NSLS2/zupsc-hw/daughter/rev2/psc_daughter_brd.kicad_pcb

## KiCad design daughter/rev2/psc_daughter_brd.kicad_pcb (2026-09-02)

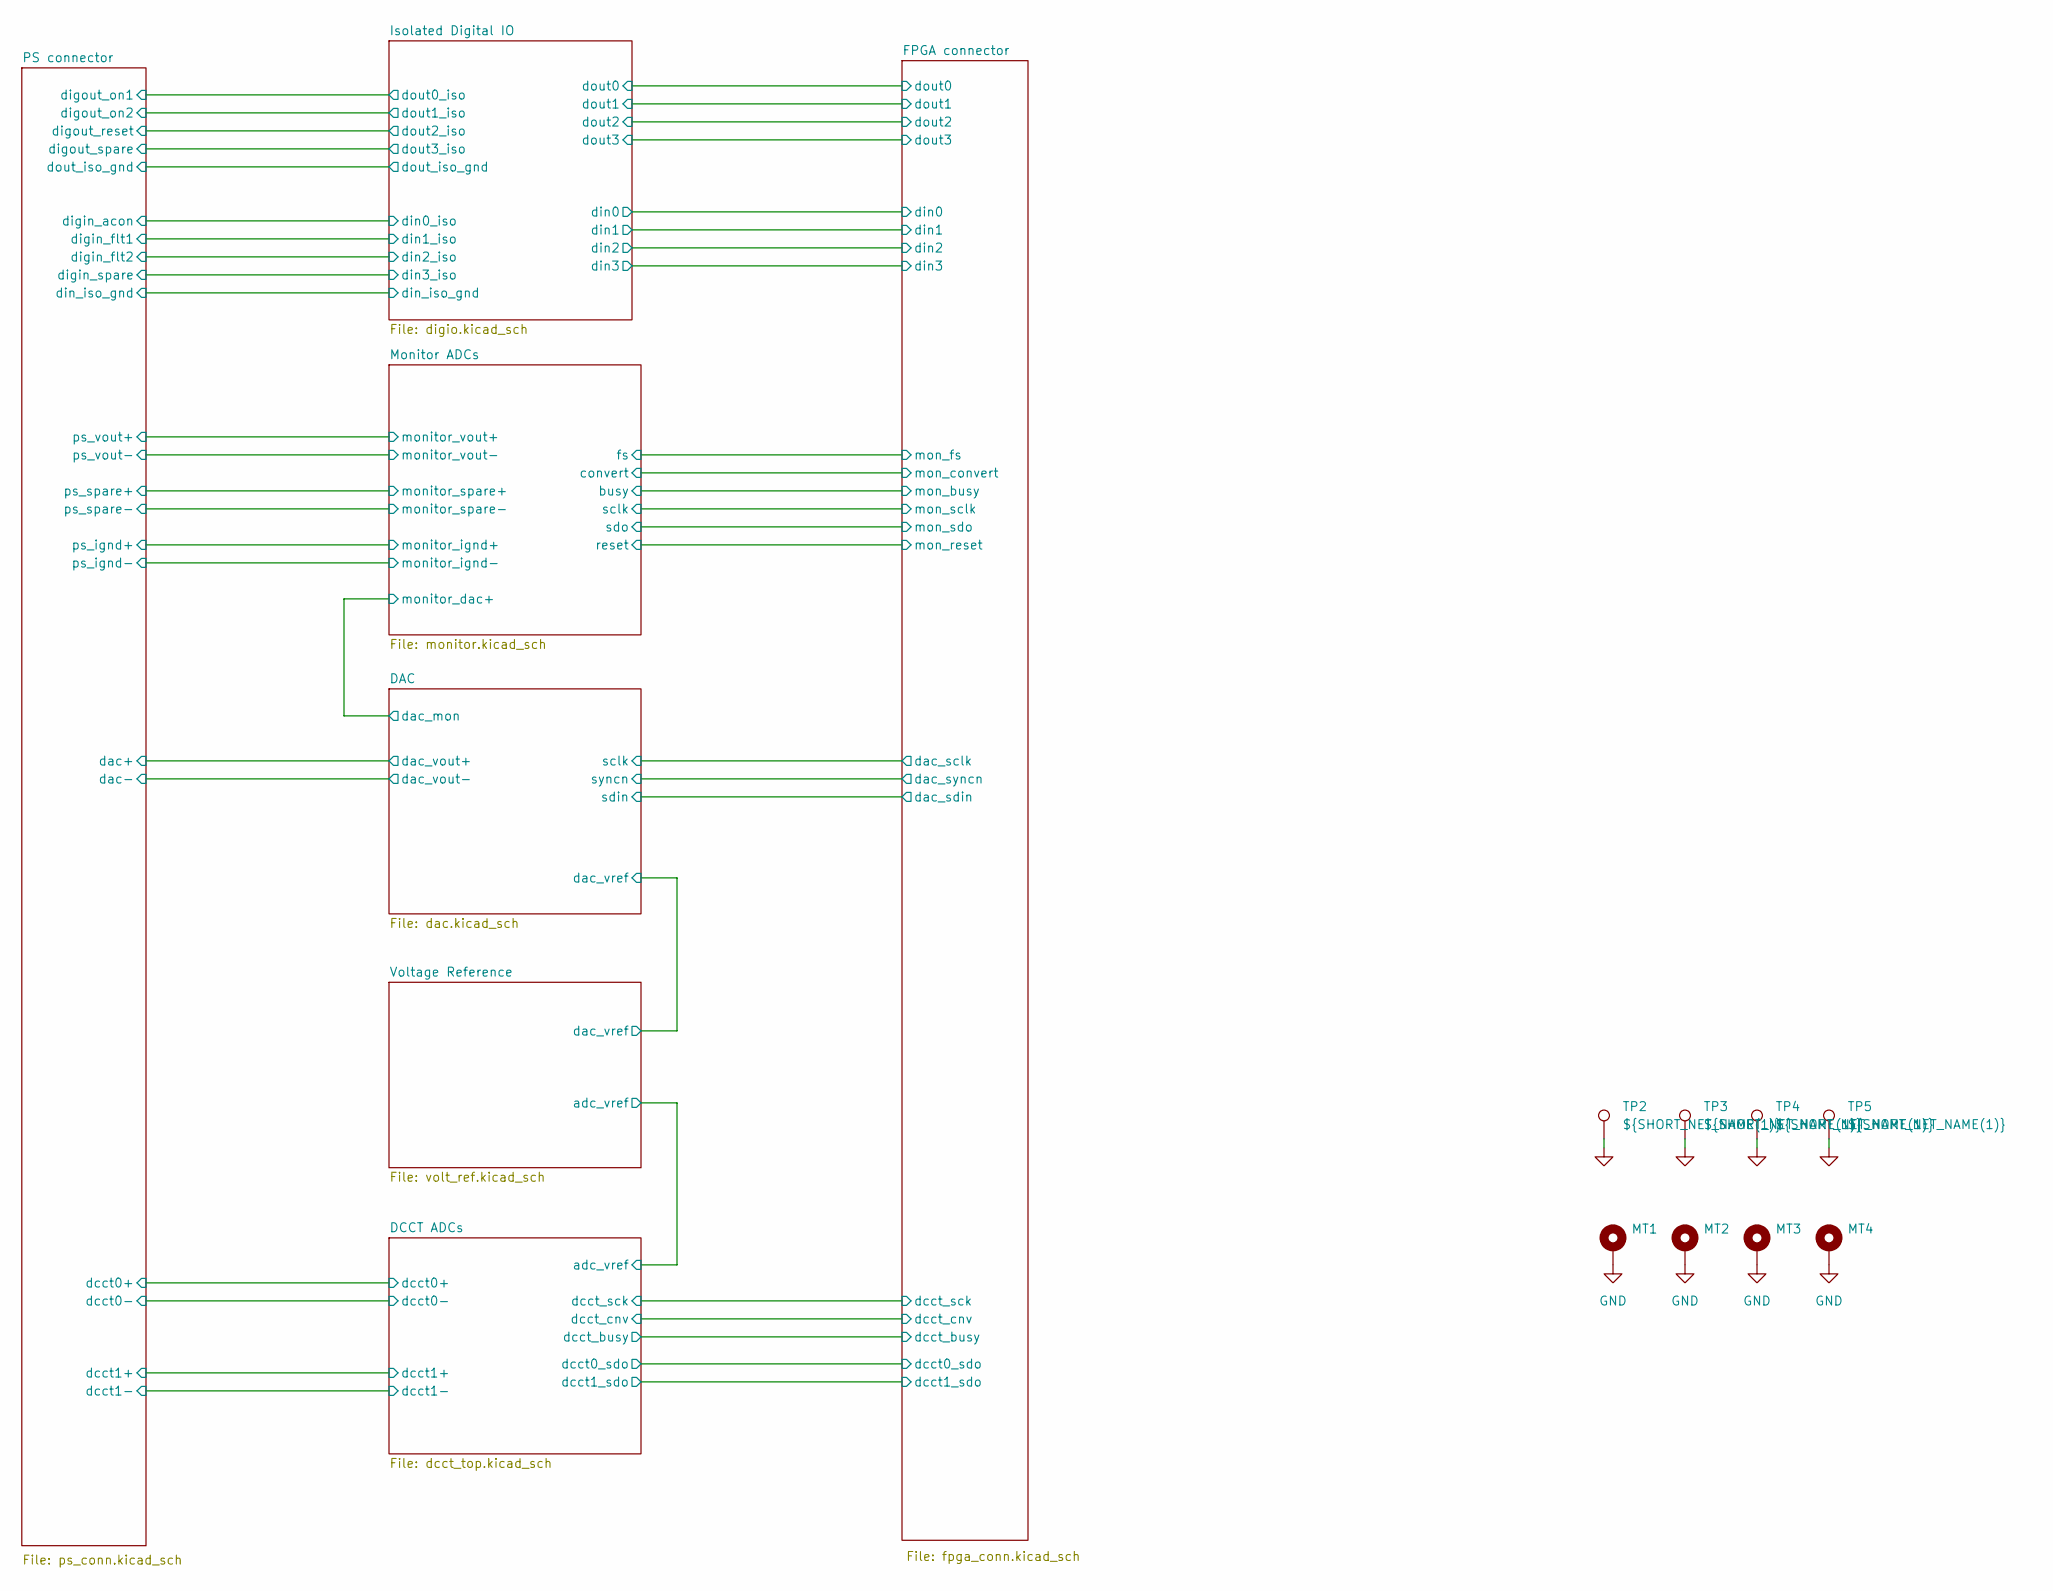
[picture p1: schematic psc_daughter_brd.kicad_sch, Power Supply Controller Daughterboard]

Parts:
MT1, MT2, MT3, MT4: MountingHole_Pad; MountingHole_3.2mm_M3_Pad_TopBottom
TP2, TP3, TP4, TP5: ${SHORT_NET_NAME(1)}; TestPoint_RCS-0C; MFG_PN RCS-0C

Connections:
GND: MT1.1, MT2.1, MT3.1, MT4.1, TP2.1, TP3.1, TP4.1, TP5.1; also elsewhere on the board

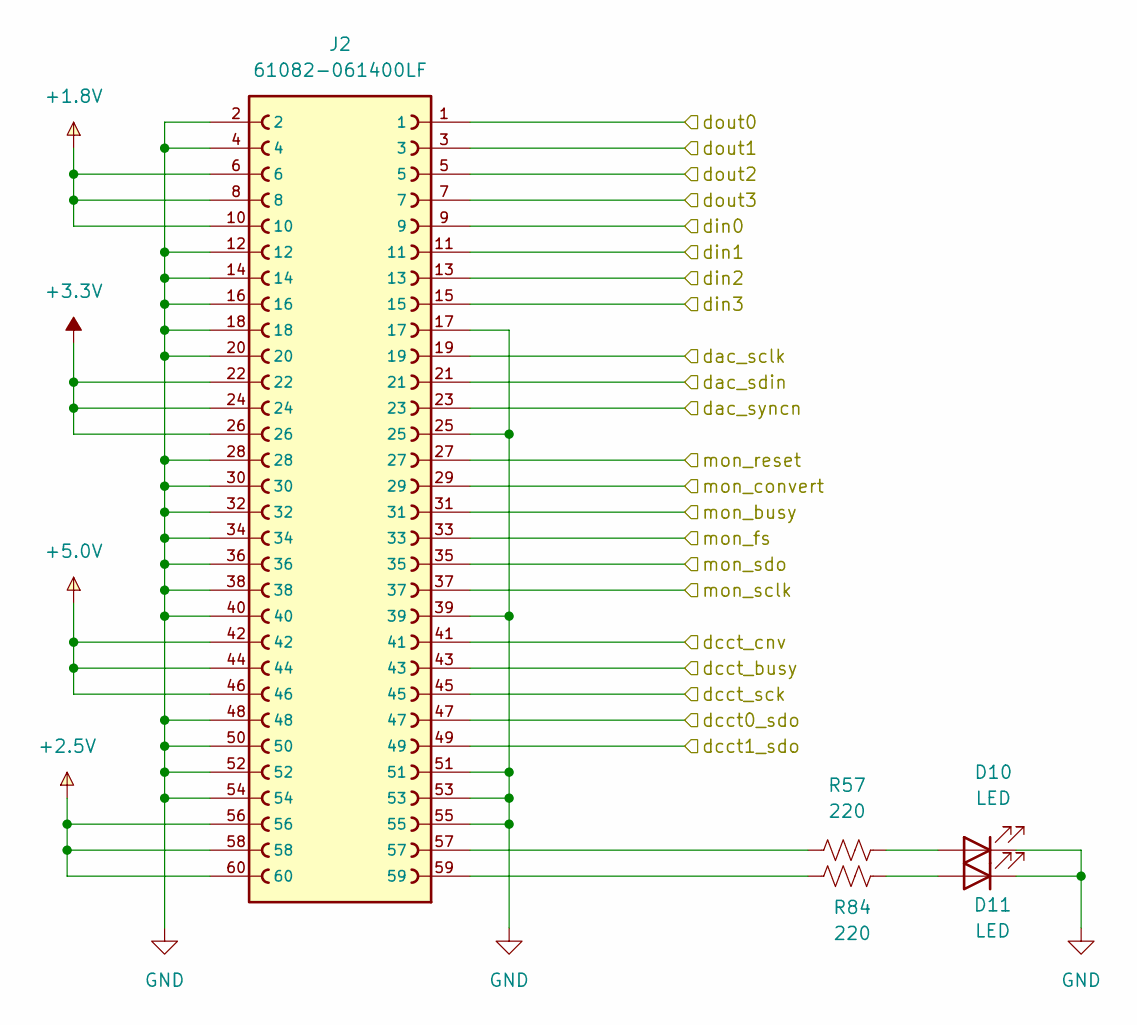
[picture p2: schematic fpga_conn.kicad_sch]

Parts:
D10, D11: LED; LED_0603_1608Metric
J2: 61082-061400LF; AMPHENOL_61082-061400LF; PARTREV AS
R57, R84: 220; R_0603_1608Metric; Tolerance 1%; MFG_PN ERJ-3EKF2200V

Connections:
+1.8V: J2.6, J2.8, J2.10; also elsewhere on the board
+2.5V: J2.56, J2.58, J2.60; also elsewhere on the board
+3.3V: J2.22, J2.24, J2.26; also elsewhere on the board
+5.0V: J2.42, J2.44, J2.46; also elsewhere on the board
/DAC/sclk: J2.19; also elsewhere on the board
/DAC/sdin: J2.21; also elsewhere on the board
/DAC/syncn: J2.23; also elsewhere on the board
/DCCT ADCs/dcct0_sdo: J2.47; also elsewhere on the board
/DCCT ADCs/dcct1_sdo: J2.49; also elsewhere on the board
/DCCT ADCs/dcct_busy: J2.43; also elsewhere on the board
/DCCT ADCs/dcct_cnv: J2.41; also elsewhere on the board
/DCCT ADCs/dcct_sck: J2.45; also elsewhere on the board
/FPGA connector/din0: J2.9; also elsewhere on the board
/FPGA connector/din1: J2.11; also elsewhere on the board
/FPGA connector/din2: J2.13; also elsewhere on the board
/FPGA connector/din3: J2.15; also elsewhere on the board
/FPGA connector/dout0: J2.1; also elsewhere on the board
/FPGA connector/dout1: J2.3; also elsewhere on the board
/FPGA connector/dout2: J2.5; also elsewhere on the board
/FPGA connector/dout3: J2.7; also elsewhere on the board
/FPGA connector/mon_busy: J2.31; also elsewhere on the board
/FPGA connector/mon_convert: J2.29; also elsewhere on the board
/FPGA connector/mon_fs: J2.33; also elsewhere on the board
/FPGA connector/mon_reset: J2.27; also elsewhere on the board
/FPGA connector/mon_sclk: J2.37; also elsewhere on the board
/FPGA connector/mon_sdo: J2.35; also elsewhere on the board
GND: D10.1 (K), D11.1 (K), J2.2, J2.4, J2.12, J2.14, J2.16, J2.17, J2.18, J2.20, J2.25, J2.28, J2.30, J2.32, J2.34, J2.36, J2.38, J2.39, J2.40, J2.48, J2.50, J2.51, J2.52, J2.53, J2.54, J2.55; also elsewhere on the board
unnamed: D10.2 (A), R57.2
unnamed: D11.2 (A), R84.2
unnamed: J2.57, R57.1
unnamed: J2.59, R84.1

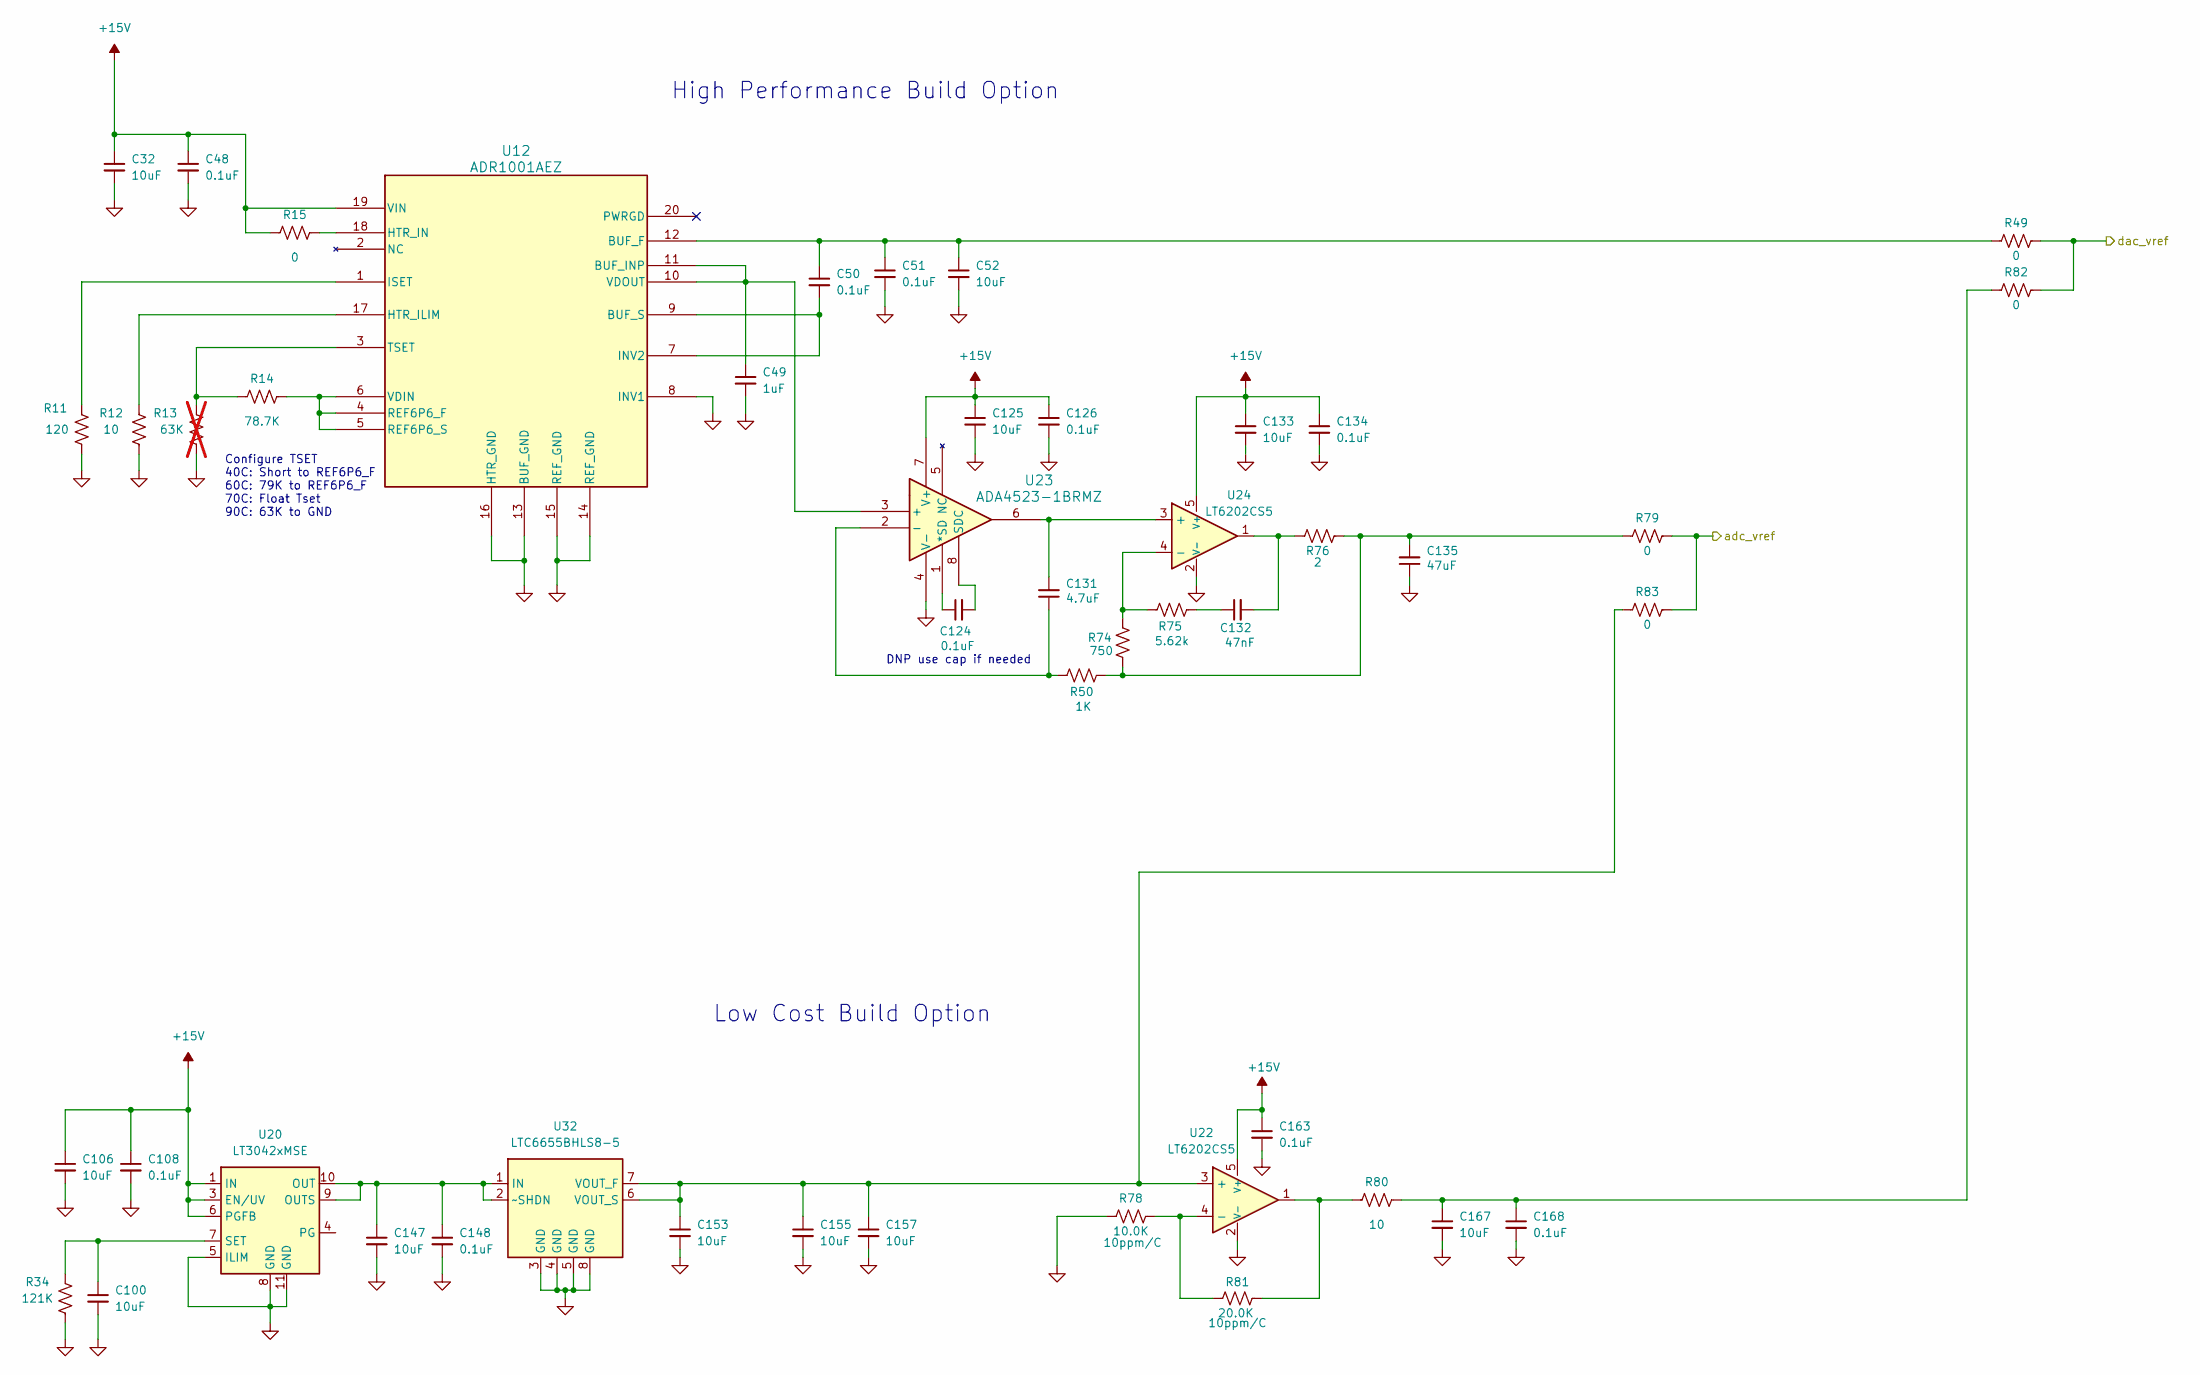
[picture p3: schematic volt_ref.kicad_sch]

Parts:
C32, C52, C100, C106, C125, C133, C147, C153, C155, C157, C167: 10uF; C_0603_1608Metric; Voltage 25V; MFG_PN CL10A106MA8NRNC
C48, C50, C51, C108, C124, C126, C134, C148, C163, C168: 0.1uF; C_0402_1005Metric; MFG_PN TMK105BJ104KV-F
C49: 1uF; C_0603_1608Metric; Voltage 25V; MFG_PN CL10B105KA8NNNC
C131: 4.7uF; C_0402_1005Metric; MFG_PN CGA4J1X7R1H475K125AC
C132: 47nF; C_0402_1005Metric; MFG_PN GRM155R71E473KA88D
C135: 47uF; C_1210_3225Metric; MFG_PN MSAST32MAB5476MPNDT1
R11: 120; R_0402_1005Metric; Tolerance 1%; MFG_PN ERJ-2RKF1200X
R12, R80: 10; R_0402_1005Metric; Tolerance 1%; MFG_PN ERJ-2RKF10R0X
R13: 63K; R_0402_1005Metric; Tolerance 1%; MFG_PN ERJ-2RKF6342X; not fitted
R14: 78.7K; R_0402_1005Metric; Tolerance 1%; MFG_PN ERJ-2RKF7872X
R15, R49, R79, R82, R83: 0; R_0402_1005Metric; Tolerance 1%; MFG_PN ERJ-2GE0R00X
R34: 121K; R_0402_1005Metric; Tolerance 1%; MFG_PN ERJ-2RKF1213X
R50: 1K; R_0402_1005Metric; Tolerance 0.1%; MFG_PN ERA-2ARB102X
R74: 750; R_0402_1005Metric; Tolerance 1%; MFG_PN ERA-2ARB751X
R75: 5.62k; R_0402_1005Metric; Tolerance 0.1%; MFG_PN ERA-2ARB5621X
R76: 2; R_0402_1005Metric; Tolerance 0.1%; MFG_PN RNCA0805BTS2K00
R78: 10.0K; R_0603_1608Metric; Tolerance 0.1%; MFG_PN RT0603BRB0710KL
R81: 20.0K; R_0603_1608Metric; Tolerance 0.1%; MFG_PN ERA-3ARB203V
U12: ADR1001AEZ; E-20-1_ADI; MFG_PN ADR1001AEZ
U20: LT3042xMSE; MSOP-10-1EP_3x3mm_P0.5mm_EP1.68x1.88mm; MFG_PN LT3042EMSE#TRPBF
U22, U24: LT6202CS5; MFG_PN LT6202CS5#TRPBF
U23: ADA4523-1BRMZ; RM-8_ADI; MFG_PN ADA4523-1BRMZ
U32: LTC6655BHLS8-5; LTC6655; MFG_PN LTC6655BHLS8-5#PBF

Connections:
+15V: C32.1, C48.1, C106.1, C108.1, C125.1, C126.1, C133.1, C134.1, C163.1, R15.2, U12.19 (VIN), U20.1 (IN), U20.2 (IN), U20.3 (EN/UV), U20.6 (PGFB), U22.5 (V+), U23.7 (V+), U24.5 (V+); also elsewhere on the board
/DAC/dac_vref: R49.1, R82.1; also elsewhere on the board
/DCCT ADCs/adc_vref: R79.1, R83.1; also elsewhere on the board
GND: C32.2, C48.2, C49.2, C51.2, C52.2, C100.2, C106.2, C108.2, C125.2, C126.2, C133.2, C134.2, C135.1, C147.2, C148.2, C153.2, C155.2, C157.2, C163.2, C167.2, C168.2, R11.1, R12.1, R13.1, R34.1, R78.2, U12.8 (INV1), U12.13 (BUF_GND), U12.14 (REF_GND), U12.15 (REF_GND), U12.16 (HTR_GND), U20.5 (ILIM), U20.8 (GND), U20.11 (GND), U22.2 (V-), U23.4 (V-), U24.2 (V-), U32.3 (GND), U32.4 (GND), U32.5 (GND), U32.8 (GND); also elsewhere on the board
unnamed: C132.1, R75.1
unnamed: C132.2, R76.2, U24.1
unnamed: C135.2, R50.1, R74.1, R76.1, R79.2
unnamed: C167.1, C168.1, R80.1, R82.2
unnamed: R80.2, R81.2, U22.1
unnamed: C50.1, C51.1, C52.1, R49.2, U12.12 (BUF_F)
unnamed: C49.1, U12.10 (VDOUT), U12.11 (BUF_INP), U23.3 (+)
unnamed: C50.2, U12.7 (INV2), U12.9 (BUF_S)
unnamed: R12.2, U12.17 (HTR_ILIM)
unnamed: R15.1, U12.18 (HTR_IN)
unnamed: R11.2, U12.1 (ISET)
unnamed: R14.1, U12.4 (REF6P6_F), U12.5 (REF6P6_S), U12.6 (VDIN)
unnamed: R13.2, R14.2, U12.3 (TSET)
unnamed: C147.1, C148.1, U20.9 (OUTS), U20.10 (OUT), U32.1 (IN), U32.2 (~SHDN)
unnamed: C100.1, R34.2, U20.7 (SET)
unnamed: C153.1, C155.1, C157.1, R83.2, U22.3 (+), U32.6 (VOUT_S), U32.7 (VOUT_F)
unnamed: R78.1, R81.1, U22.4 (-)
unnamed: C124.1, U23.1 (*SD)
unnamed: C131.1, R50.2, U23.2 (-)
unnamed: C124.2, U23.8 (SDC)
unnamed: C131.2, U23.6, U24.3 (+)
unnamed: R74.2, R75.2, U24.4 (-)

Notes on the sheet:
Configure TSET 40C: Short to REF6P6_F 60C: 79K to REF6P6_F 70C: Float Tset 90C: 63K to GND
High Performance Build Option
DNP use cap if needed
Low Cost Build Option

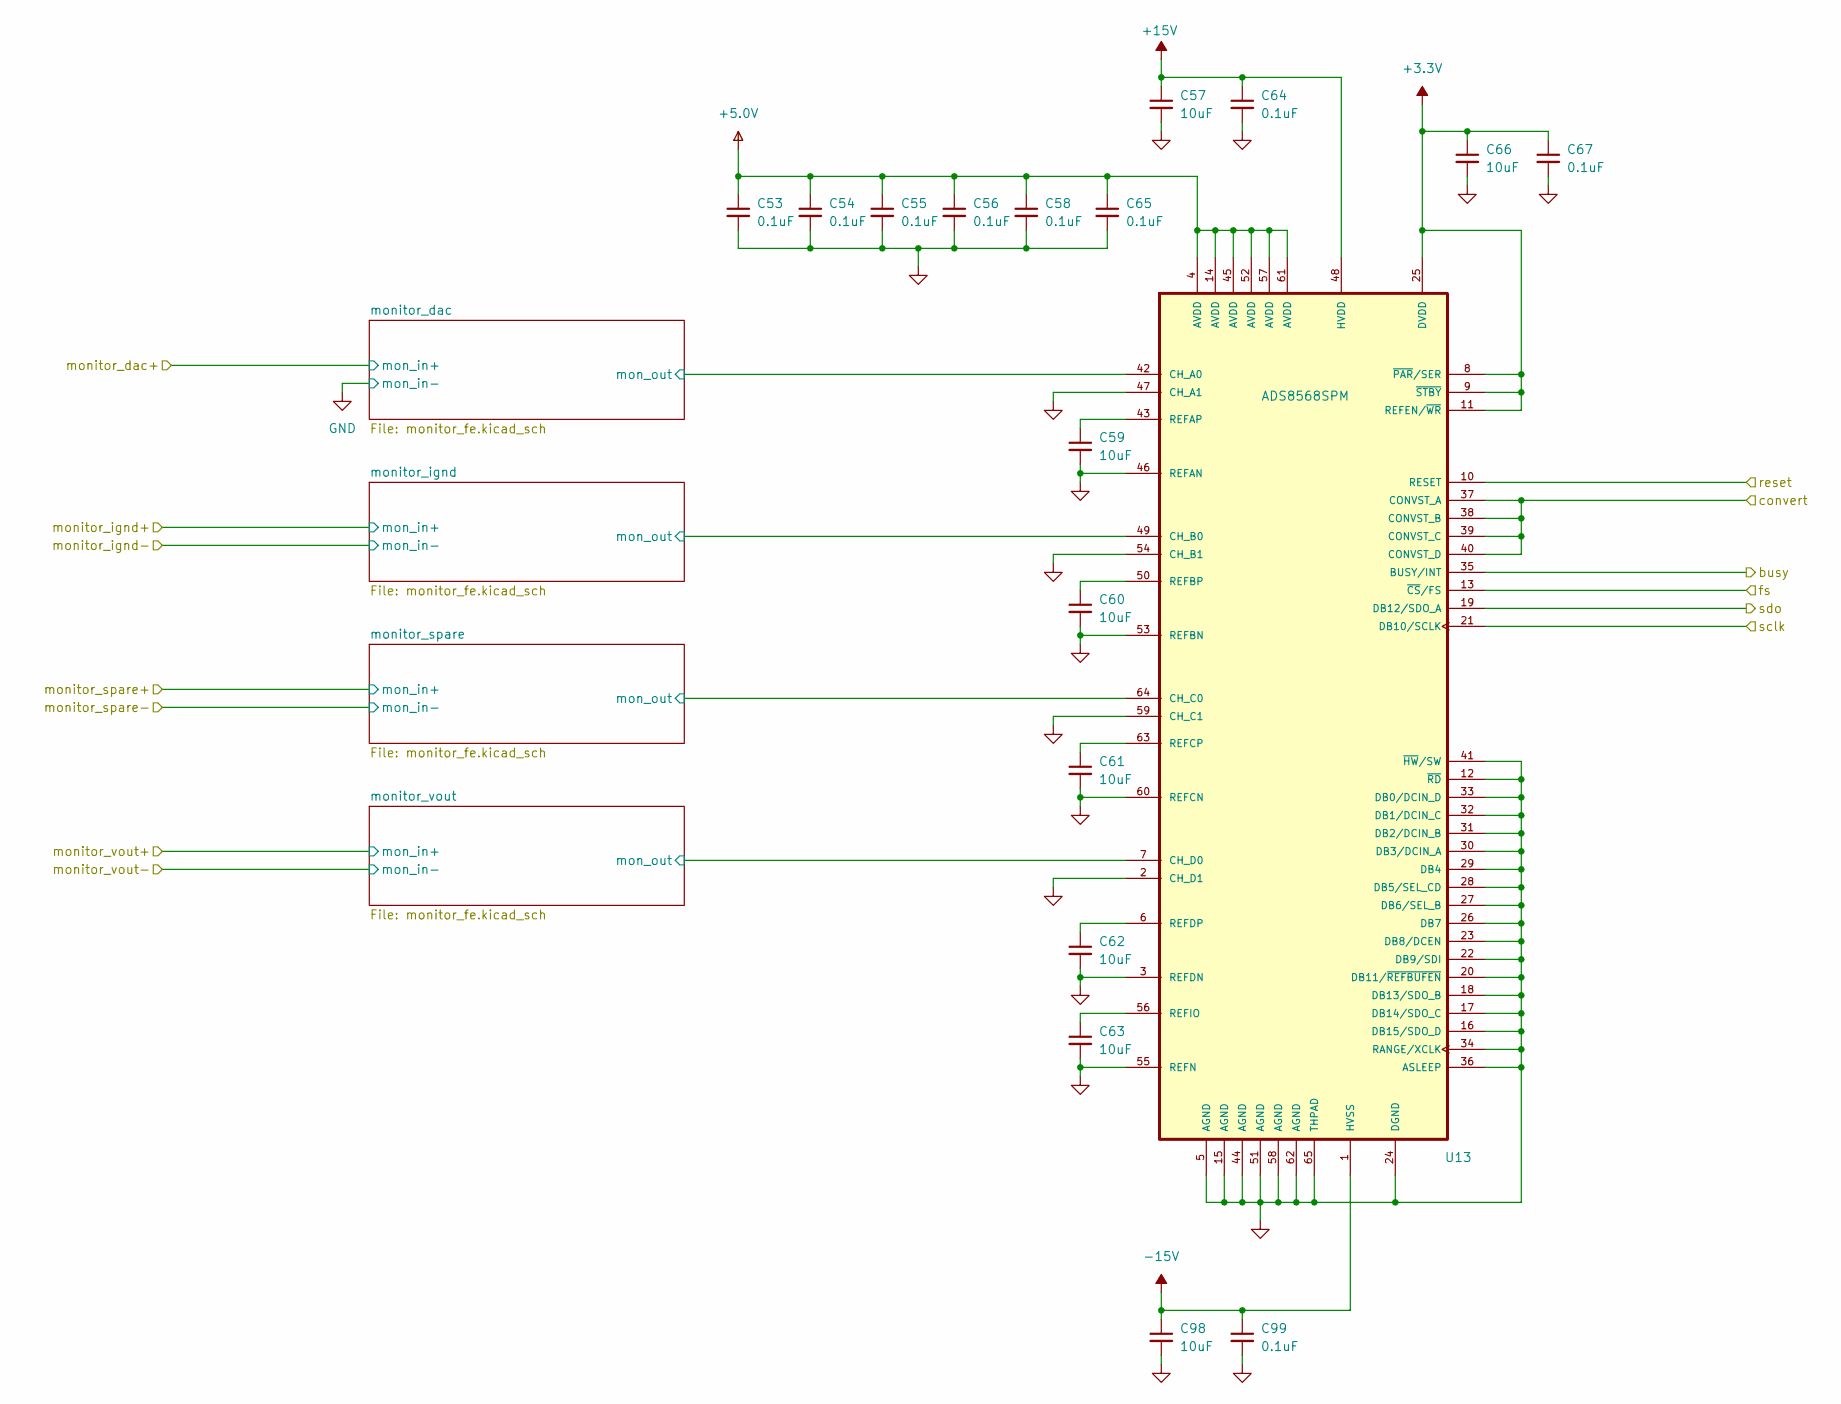
[picture p4: schematic monitor.kicad_sch]

Parts:
C53, C54, C55, C56, C58, C64, C65, C67, C99: 0.1uF; C_0402_1005Metric; MFG_PN TMK105BJ104KV-F
C57, C59, C60, C61, C62, C63, C66, C98: 10uF; C_0603_1608Metric; Voltage 25V; MFG_PN CL10A106MA8NRNC
U13: ADS8568SPM; QFP50P1200X1200X160-64N; MFG_PN ADS8568SPM

Connections:
+3.3V: C66.1, C67.1, U13.8 (~PAR/SER), U13.9 (~STBY), U13.11 (REFEN/~WR), U13.25 (DVDD); also elsewhere on the board
+5.0V: C53.1, C54.1, C55.1, C56.1, C58.1, C65.1, U13.4 (AVDD), U13.14 (AVDD), U13.45 (AVDD), U13.52 (AVDD), U13.57 (AVDD), U13.61 (AVDD); also elsewhere on the board
+15V: C57.1, C64.1, U13.48 (HVDD); also elsewhere on the board
-15V: C98.1, C99.1, U13.1 (HVSS); also elsewhere on the board
/FPGA connector/mon_busy: U13.35 (BUSY/INT); also elsewhere on the board
/FPGA connector/mon_convert: U13.37 (CONVST_A), U13.38 (CONVST_B), U13.39 (CONVST_C), U13.40 (CONVST_D); also elsewhere on the board
/FPGA connector/mon_fs: U13.13 (~CS/FS); also elsewhere on the board
/FPGA connector/mon_reset: U13.10 (RESET); also elsewhere on the board
/FPGA connector/mon_sclk: U13.21 (DB10/SCLK); also elsewhere on the board
/FPGA connector/mon_sdo: U13.19 (DB12/SDO_A); also elsewhere on the board
/Monitor ADCs/monitor_dac/mon_out: U13.42 (CH_A0); also elsewhere on the board
/Monitor ADCs/monitor_ignd/mon_out: U13.49 (CH_B0); also elsewhere on the board
/Monitor ADCs/monitor_spare/mon_out: U13.64 (CH_C0); also elsewhere on the board
/Monitor ADCs/monitor_vout/mon_out: U13.7 (CH_D0); also elsewhere on the board
GND: C53.2, C54.2, C55.2, C56.2, C57.2, C58.2, C59.2, C60.2, C61.2, C62.2, C63.2, C64.2, C65.2, C66.2, C67.2, C98.2, C99.2, U13.2 (CH_D1), U13.3 (REFDN), U13.5 (AGND), U13.12 (~RD), U13.15 (AGND), U13.16 (DB15/SDO_D), U13.17 (DB14/SDO_C), U13.18 (DB13/SDO_B), U13.20 (DB11/~REFBUFEN), U13.22 (DB9/SDI), U13.23 (DB8/DCEN), U13.24 (DGND), U13.26 (DB7), U13.27 (DB6/SEL_B), U13.28 (DB5/SEL_CD), U13.29 (DB4), U13.30 (DB3/DCIN_A), U13.31 (DB2/DCIN_B), U13.32 (DB1/DCIN_C), U13.33 (DB0/DCIN_D), U13.34 (RANGE/XCLK), U13.36 (ASLEEP), U13.41 (~HW/SW), U13.44 (AGND), U13.46 (REFAN), U13.47 (CH_A1), U13.51 (AGND), U13.53 (REFBN), U13.54 (CH_B1), U13.55 (REFN), U13.58 (AGND), U13.59 (CH_C1), U13.60 (REFCN), U13.62 (AGND), U13.65 (THPAD); also elsewhere on the board
unnamed: C59.1, U13.43 (REFAP)
unnamed: C60.1, U13.50 (REFBP)
unnamed: C61.1, U13.63 (REFCP)
unnamed: C62.1, U13.6 (REFDP)
unnamed: C63.1, U13.56 (REFIO)

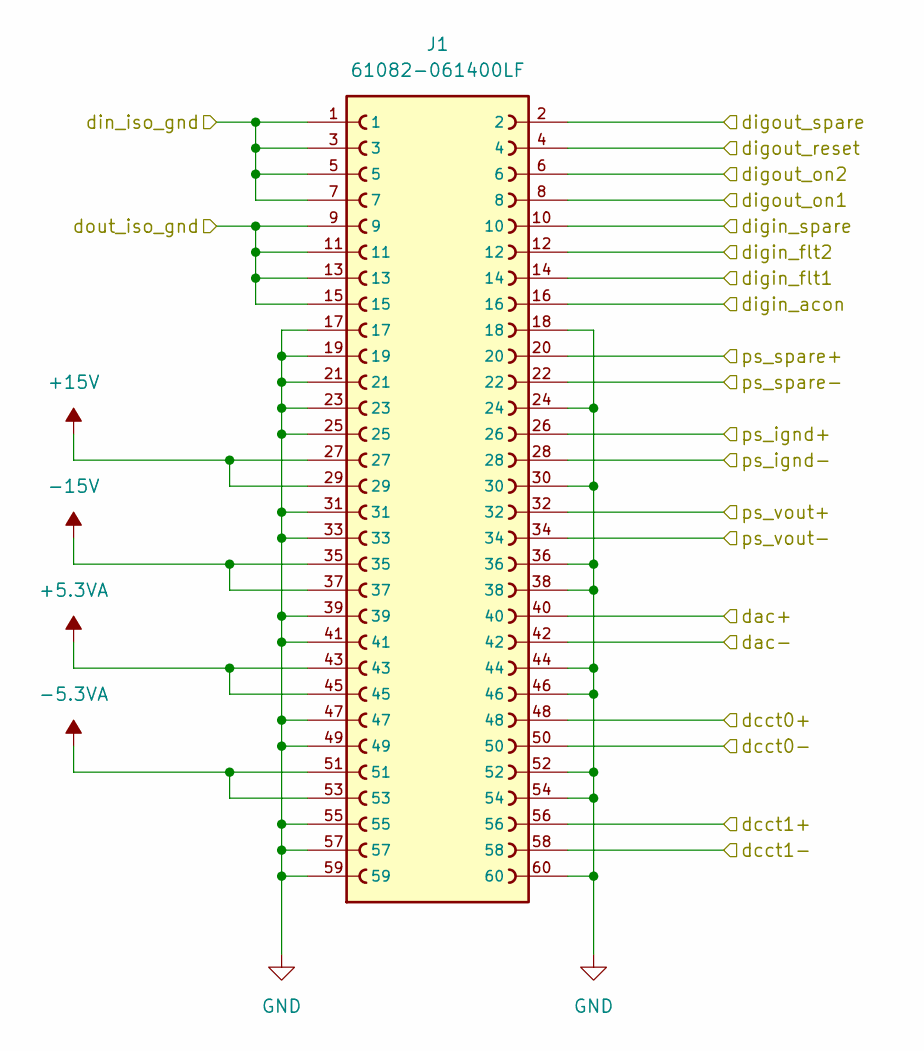
[picture p5: schematic ps_conn.kicad_sch]

Parts:
J1: 61082-061400LF; AMPHENOL_61082-061400LF; PARTREV AS

Connections:
+5.3VA: J1.43, J1.45; also elsewhere on the board
+15V: J1.27, J1.29; also elsewhere on the board
-5.3VA: J1.51, J1.53; also elsewhere on the board
-15V: J1.35, J1.37; also elsewhere on the board
/DAC/dac_vout+: J1.40; also elsewhere on the board
/DAC/dac_vout-: J1.42; also elsewhere on the board
/DCCT ADCs/dcct0+: J1.48; also elsewhere on the board
/DCCT ADCs/dcct0-: J1.50; also elsewhere on the board
/DCCT ADCs/dcct1+: J1.56; also elsewhere on the board
/DCCT ADCs/dcct1-: J1.58; also elsewhere on the board
/Isolated Digital IO/din0_iso: J1.16; also elsewhere on the board
/Isolated Digital IO/din1_iso: J1.14; also elsewhere on the board
/Isolated Digital IO/din2_iso: J1.12; also elsewhere on the board
/Isolated Digital IO/din3_iso: J1.10; also elsewhere on the board
/Isolated Digital IO/din_iso_gnd: J1.1, J1.3, J1.5, J1.7; also elsewhere on the board
/Isolated Digital IO/dout0_iso: J1.8; also elsewhere on the board
/Isolated Digital IO/dout1_iso: J1.6; also elsewhere on the board
/Isolated Digital IO/dout2_iso: J1.4; also elsewhere on the board
/Isolated Digital IO/dout3_iso: J1.2; also elsewhere on the board
/Isolated Digital IO/dout_iso_gnd: J1.9, J1.11, J1.13, J1.15; also elsewhere on the board
/Monitor ADCs/monitor_ignd+: J1.26; also elsewhere on the board
/Monitor ADCs/monitor_ignd-: J1.28; also elsewhere on the board
/Monitor ADCs/monitor_spare+: J1.20; also elsewhere on the board
/Monitor ADCs/monitor_spare-: J1.22; also elsewhere on the board
/Monitor ADCs/monitor_vout+: J1.32; also elsewhere on the board
/Monitor ADCs/monitor_vout-: J1.34; also elsewhere on the board
GND: J1.17, J1.18, J1.19, J1.21, J1.23, J1.24, J1.25, J1.30, J1.31, J1.33, J1.36, J1.38, J1.39, J1.41, J1.44, J1.46, J1.47, J1.49, J1.52, J1.54, J1.55, J1.57, J1.59, J1.60; also elsewhere on the board

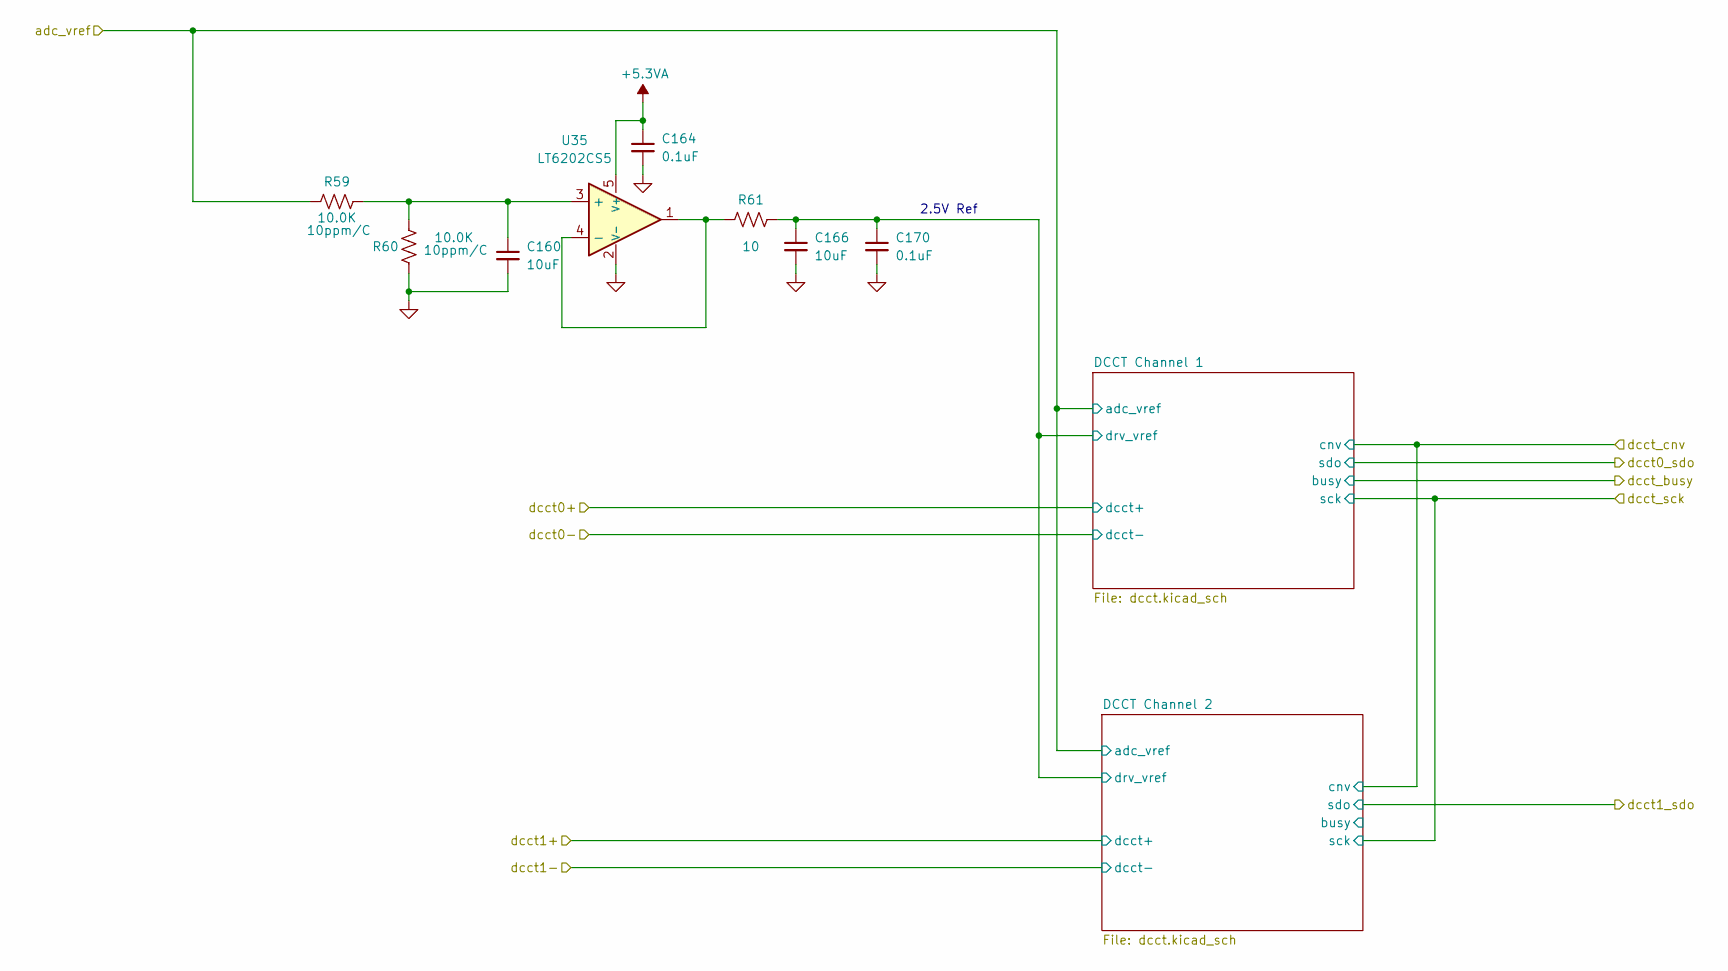
[picture p6: schematic dcct_top.kicad_sch]

Parts:
C160, C166: 10uF; C_0603_1608Metric; Voltage 25V; MFG_PN CL10A106MA8NRNC
C164, C170: 0.1uF; C_0402_1005Metric; MFG_PN TMK105BJ104KV-F
R59, R60: 10.0K; R_0603_1608Metric; Tolerance 0.1%; MFG_PN RT0603BRB0710KL
R61: 10; R_0402_1005Metric; Tolerance 1%; MFG_PN ERJ-2RKF10R0X
U35: LT6202CS5; MFG_PN LT6202CS5#TRPBF

Connections:
+5.3VA: C164.1, U35.5 (V+); also elsewhere on the board
/DCCT ADCs/DCCT Channel 1/drv_vref: C166.1, C170.1, R61.1; also elsewhere on the board
/DCCT ADCs/adc_vref: R59.2; also elsewhere on the board
GND: C160.2, C164.2, C166.2, C170.2, R60.1, U35.2 (V-); also elsewhere on the board
unnamed: C160.1, R59.1, R60.2, U35.3 (+)
unnamed: R61.2, U35.1, U35.4 (-)

Notes on the sheet:
2.5V Ref
