NSLS2/zupsc-hw/daughter/rev2/psc_daughter_brd.kicad_pcb

## KiCad design daughter/rev2/psc_daughter_brd.kicad_pcb (continued)

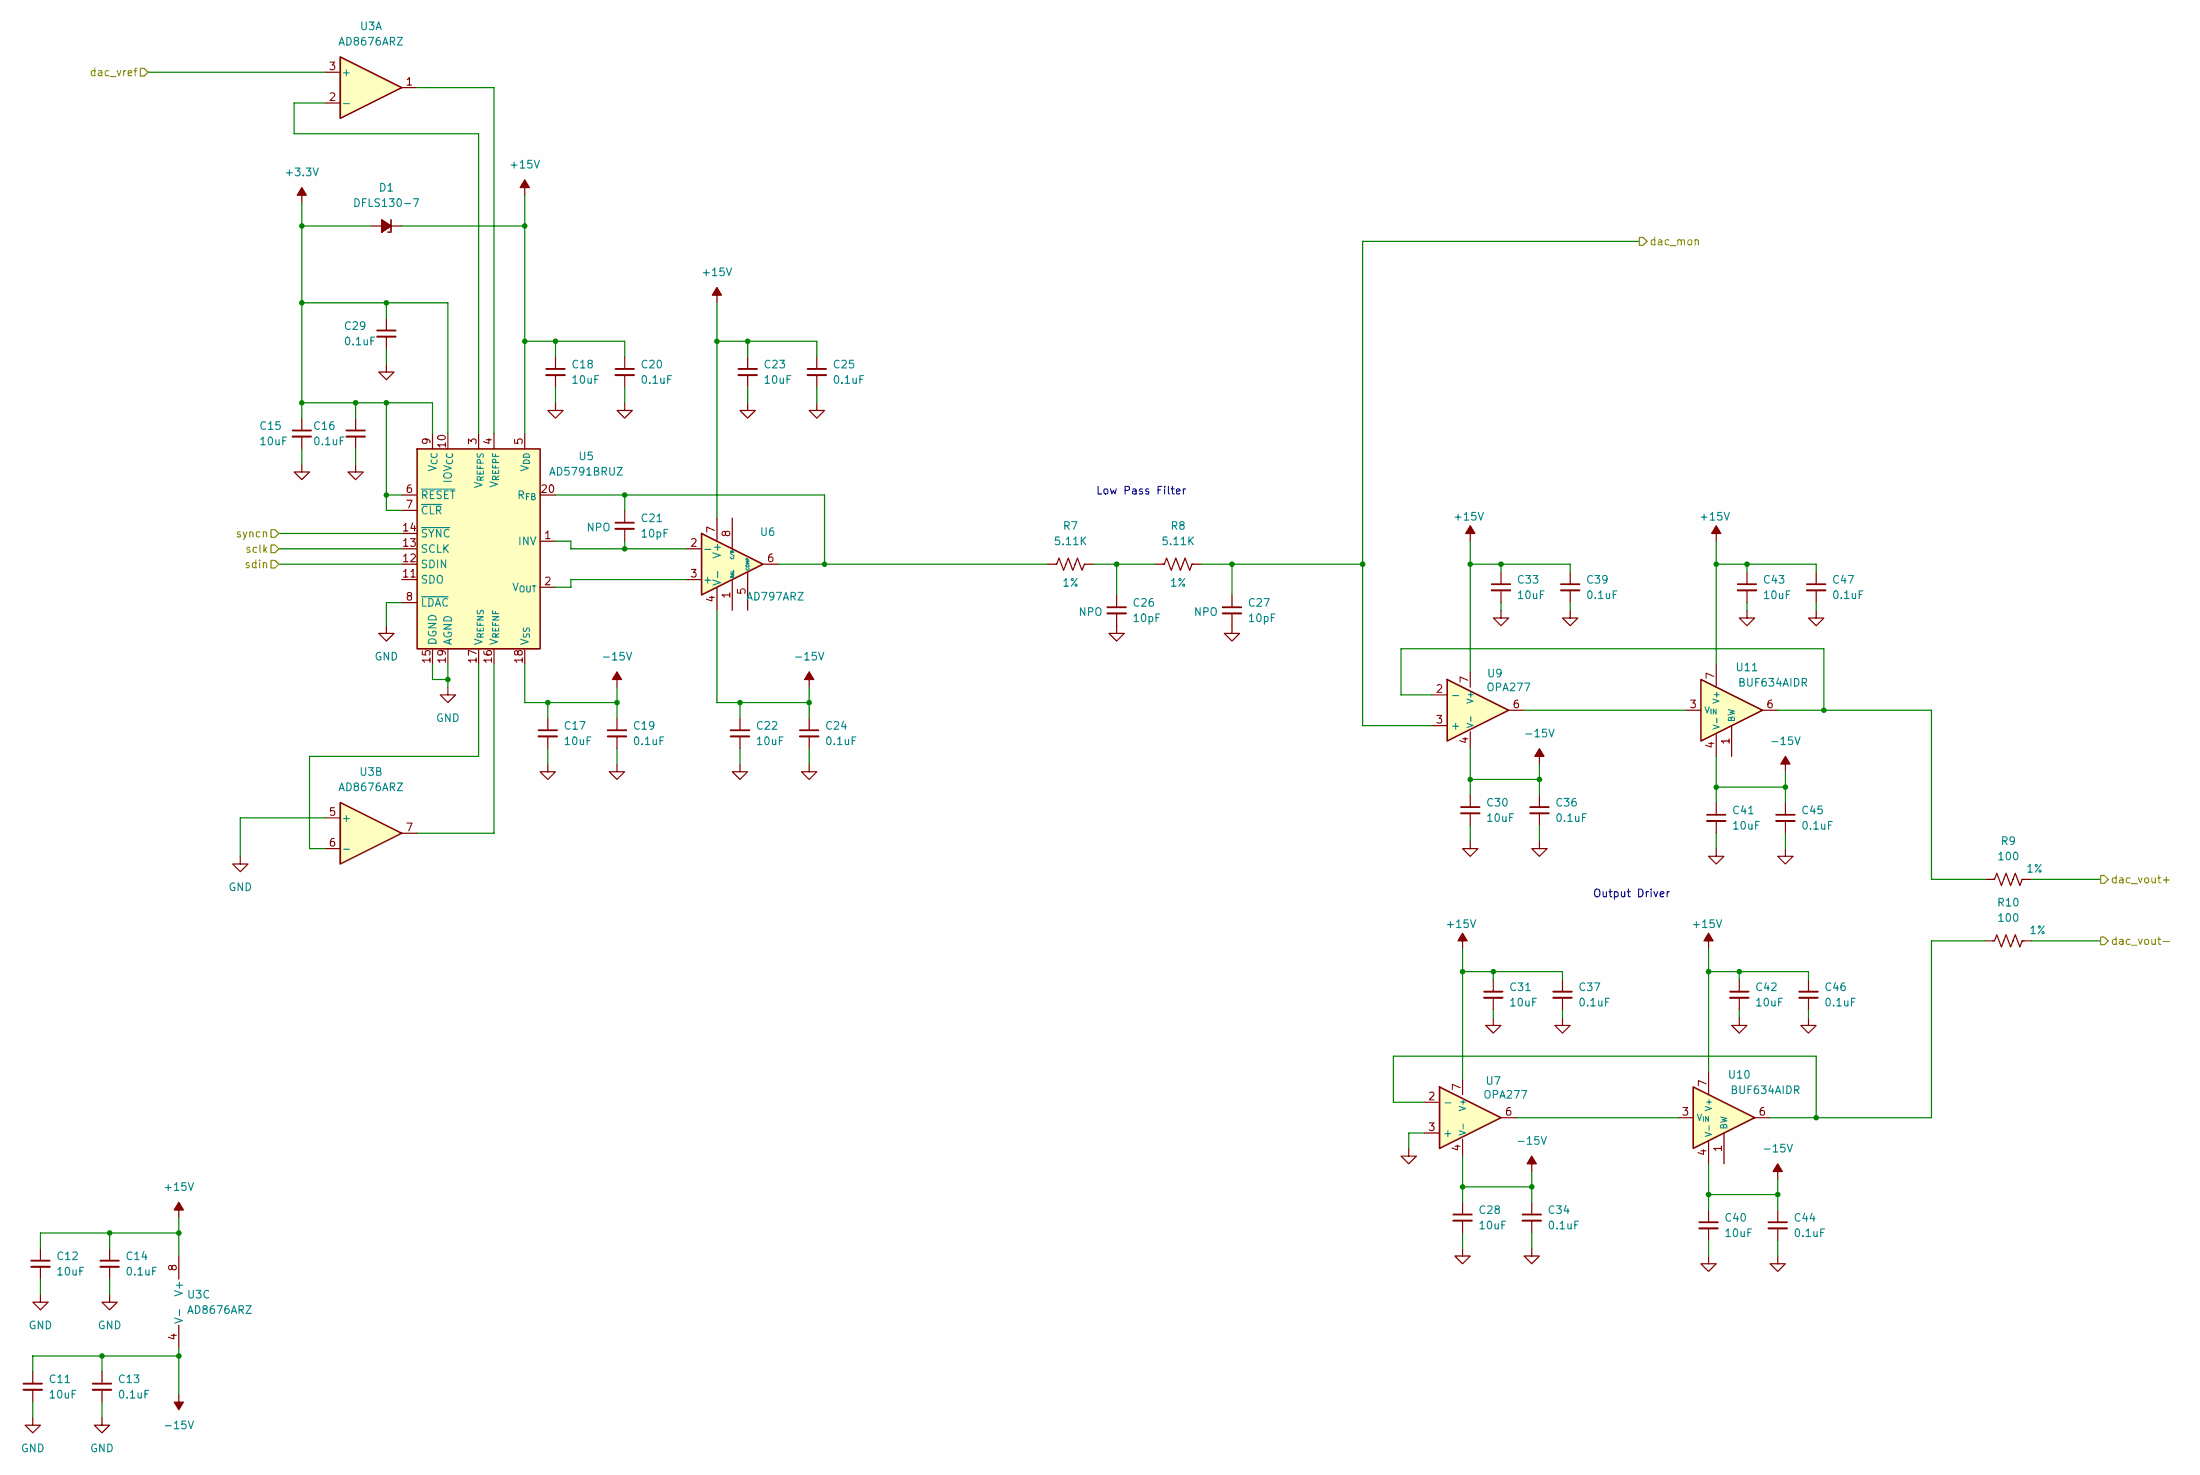
[picture p7: schematic dac.kicad_sch]

Parts:
C11, C12, C15, C17, C18, C22, C23, C28, C30, C31, C33, C40, C41, C42, C43: 10uF; C_0603_1608Metric; Voltage 25V; MFG_PN CL10A106MA8NRNC
C13, C14, C16, C19, C20, C24, C25, C29, C34, C36, C37, C39, C44, C45, C46, C47: 0.1uF; C_0402_1005Metric; MFG_PN TMK105BJ104KV-F
C21, C26, C27: 10pF; C_0402_1005Metric; MFG_PN C0402C100K5RACTU
D1: DFLS130-7; DFLS130-7_DIO; MFG_PN DFLS130-7
R7, R8: 5.11K; R_0402_1005Metric; Tolerance 1%; MFG_PN ERJ-2RKF5111X
R9, R10: 100; R_0603_1608Metric; Tolerance 1%; MFG_PN ERJ-2RKF15R0X
U3: AD8676ARZ; SOIC-8_3.9x4.9mm_P1.27mm; MFG_PN AD8676ARZ-REEL7
U5: AD5791BRUZ; TSSOP-20_4.4x6.5mm_P0.65mm; MFG_PN AD5791BRUZ
U6: AD797ARZ; SOIC-8_3.9x4.9mm_P1.27mm; MFG_PN AD797ARZ
U7, U9: OPA277; SOIC-8_3.9x4.9mm_P1.27mm; MFG_PN OPA277UA/2K5
U10, U11: BUF634AIDR; SOIC-8_3.9x4.9mm_P1.27mm; MFG_PN BUF634AIDR

Connections:
+3.3V: C15.1, C16.1, C29.1, D1.2 (A), U5.6 (~RESET), U5.7 (~CLR), U5.9 (V_{CC}), U5.10 (IOV_{CC}); also elsewhere on the board
+15V: C12.1, C14.1, C18.1, C20.1, C23.1, C25.1, C31.1, C33.1, C37.1, C39.1, C42.1, C43.1, C46.1, C47.1, D1.1 (K), U3.8 (V+), U5.5 (V_{DD}), U6.7 (V+), U7.7 (V+), U9.7 (V+), U10.7 (V+), U11.7 (V+); also elsewhere on the board
-15V: C11.1, C13.1, C17.1, C19.1, C22.1, C24.1, C28.1, C30.1, C34.1, C36.1, C40.1, C41.1, C44.1, C45.1, U3.4 (V-), U5.18 (V_{SS}), U6.4 (V-), U7.4 (V-), U9.4 (V-), U10.4 (V-), U11.4 (V-); also elsewhere on the board
/DAC/dac_mon: C27.1, R8.2, U9.3 (+); also elsewhere on the board
/DAC/dac_vout+: R9.2; also elsewhere on the board
/DAC/dac_vout-: R10.2; also elsewhere on the board
/DAC/dac_vref: U3.3 (+); also elsewhere on the board
/DAC/sclk: U5.13 (SCLK); also elsewhere on the board
/DAC/sdin: U5.12 (SDIN); also elsewhere on the board
/DAC/syncn: U5.14 (~SYNC); also elsewhere on the board
GND: C11.2, C12.2, C13.2, C14.2, C15.2, C16.2, C17.2, C18.2, C19.2, C20.2, C22.2, C23.2, C24.2, C25.2, C26.2, C27.2, C28.2, C29.2, C30.2, C31.2, C33.2, C34.2, C36.2, C37.2, C39.2, C40.2, C41.2, C42.2, C43.2, C44.2, C45.2, C46.2, C47.2, U3.5 (+), U5.8 (~LDAC), U5.15 (DGND), U5.19 (AGND), U7.3 (+); also elsewhere on the board
unnamed: C26.1, R7.2, R8.1
unnamed: U3.2 (-), U5.3 (V_{REFPS})
unnamed: U3.6 (-), U5.17 (V_{REFNS})
unnamed: C21.2, U5.1 (INV), U6.2 (-)
unnamed: C21.1, R7.1, U5.20 (R_{FB}), U6.6
unnamed: U5.2 (V_{OUT}), U6.3 (+)
unnamed: U3.7, U5.16 (V_{REFNF})
unnamed: U3.1, U5.4 (V_{REFPF})
unnamed: R10.1, U7.2 (-), U10.6
unnamed: R9.1, U9.2 (-), U11.6
unnamed: U7.6, U10.3 (V_{IN})
unnamed: U9.6, U11.3 (V_{IN})

Notes on the sheet:
Output Driver
Low Pass Filter

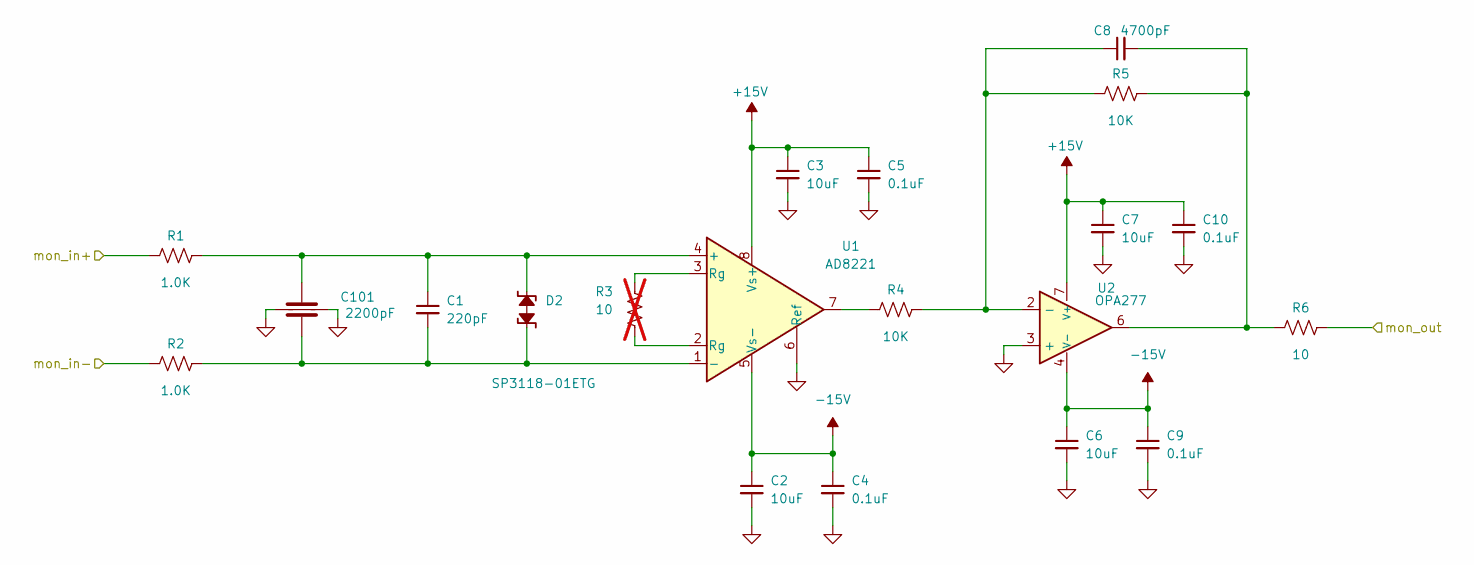
[picture p8: schematic monitor_fe.kicad_sch]

Parts:
C1: 220pF; C_0402_1005Metric; MFG_PN C0402C221K5RACTU
C2, C3, C6, C7: 10uF; C_0603_1608Metric; Voltage 25V; MFG_PN CL10A106MA8NRNC
C4, C5, C9, C10: 0.1uF; C_0402_1005Metric; MFG_PN TMK105BJ104KV-F
C8: 4700pF; C_0402_1005Metric; MFG_PN CL05B472KB5NNNC
C101: 2200pF; EMCT101W222M1GV001E; MFG_PN EMCT101W222M1GV001E
D2: SP3118-01ETG; sp3118-01etg; MFG_PN SP3118-01ETG
R1, R2: 1.0K; R_0402_1005Metric; Tolerance 1%; MFG_PN ERJ-2RKF1001X
R3: 10; R_0402_1005Metric; Tolerance 1%; MFG_PN ERJ-2RKF10R0X; not fitted
R4, R5: 10K; R_0402_1005Metric; Tolerance 1%; MFG_PN ERJ-2RKF1002X
R6: 10; R_0402_1005Metric; Tolerance 1%; MFG_PN ERJ-2RKF10R0X
U1: AD8221; SOIC127P600X175-8N; MFG_PN AD8221BRZ
U2: OPA277; SOIC-8_3.9x4.9mm_P1.27mm; MFG_PN OPA277UA/2K5

Connections:
+15V: C3.1, C5.1, C7.1, C10.1, U1.8 (Vs+), U2.7 (V+); also elsewhere on the board
-15V: C2.1, C4.1, C6.1, C9.1, U1.5 (Vs-), U2.4 (V-); also elsewhere on the board
/Monitor ADCs/monitor_ignd+: R1.2; also elsewhere on the board
/Monitor ADCs/monitor_ignd-: R2.2; also elsewhere on the board
/Monitor ADCs/monitor_ignd/mon_out: R6.1; also elsewhere on the board
GND: C2.2, C3.2, C4.2, C5.2, C6.2, C7.2, C9.2, C10.2, C101.3, C101.4, U1.6 (Ref), U2.3 (+); also elsewhere on the board
unnamed: C8.2, R5.1, R6.2, U2.6
unnamed: C1.2, C101.2, D2.1 (A1), R2.1, U1.1 (-)
unnamed: C1.1, C101.1, D2.2 (A2), R1.1, U1.4 (+)
unnamed: R3.1, U1.2 (Rg)
unnamed: R3.2, U1.3 (Rg)
unnamed: R4.2, U1.7
unnamed: C8.1, R4.1, R5.2, U2.2 (-)

Parts of its further copies:
C68, C78, C88: 220pF; C_0402_1005Metric; MFG_PN C0402C221K5RACTU
C69, C70, C73, C74, C79, C80, C83, C84, C89, C90, C93, C94: 10uF; C_0603_1608Metric; Voltage 25V; MFG_PN CL10A106MA8NRNC
C71, C72, C76, C77, C81, C82, C86, C87, C91, C92, C96, C97: 0.1uF; C_0402_1005Metric; MFG_PN TMK105BJ104KV-F
C75, C85, C95: 4700pF; C_0402_1005Metric; MFG_PN CL05B472KB5NNNC
C103, C105, C107: 2200pF; EMCT101W222M1GV001E; MFG_PN EMCT101W222M1GV001E
D3, D6, D7: SP3118-01ETG; sp3118-01etg; MFG_PN SP3118-01ETG
R16, R17, R22, R23, R28, R29: 1.0K; R_0402_1005Metric; Tolerance 1%; MFG_PN ERJ-2RKF1001X
R18, R24, R30: 10; R_0402_1005Metric; Tolerance 1%; MFG_PN ERJ-2RKF10R0X; not fitted
R19, R20, R25, R26, R31, R32: 10K; R_0402_1005Metric; Tolerance 1%; MFG_PN ERJ-2RKF1002X
R21, R27, R33: 10; R_0402_1005Metric; Tolerance 1%; MFG_PN ERJ-2RKF10R0X
U14, U16, U18: AD8221; SOIC127P600X175-8N; MFG_PN AD8221BRZ
U15, U17, U19: OPA277; SOIC-8_3.9x4.9mm_P1.27mm; MFG_PN OPA277UA/2K5

Connections of its further copies:
+15V: C70.1, C72.1, C74.1, C77.1, C80.1, C82.1, C84.1, C87.1, C90.1, C92.1, C94.1, C97.1, U14.8 (Vs+), U15.7 (V+), U16.8 (Vs+), U17.7 (V+), U18.8 (Vs+), U19.7 (V+); also elsewhere on the board
-15V: C69.1, C71.1, C73.1, C76.1, C79.1, C81.1, C83.1, C86.1, C89.1, C91.1, C93.1, C96.1, U14.5 (Vs-), U15.4 (V-), U16.5 (Vs-), U17.4 (V-), U18.5 (Vs-), U19.4 (V-); also elsewhere on the board
/DAC/dac_mon: R16.2; also elsewhere on the board
/Monitor ADCs/monitor_dac/mon_out: R21.1; also elsewhere on the board
/Monitor ADCs/monitor_spare+: R22.2; also elsewhere on the board
/Monitor ADCs/monitor_spare-: R23.2; also elsewhere on the board
/Monitor ADCs/monitor_spare/mon_out: R27.1; also elsewhere on the board
/Monitor ADCs/monitor_vout+: R28.2; also elsewhere on the board
/Monitor ADCs/monitor_vout-: R29.2; also elsewhere on the board
/Monitor ADCs/monitor_vout/mon_out: R33.1; also elsewhere on the board
GND: C69.2, C70.2, C71.2, C72.2, C73.2, C74.2, C76.2, C77.2, C79.2, C80.2, C81.2, C82.2, C83.2, C84.2, C86.2, C87.2, C89.2, C90.2, C91.2, C92.2, C93.2, C94.2, C96.2, C97.2, C103.3, C103.4, C105.3, C105.4, C107.3, C107.4, R17.2, U14.6 (Ref), U15.3 (+), U16.6 (Ref), U17.3 (+), U18.6 (Ref), U19.3 (+); also elsewhere on the board
unnamed: C75.2, R20.1, R21.2, U15.6
unnamed: C85.2, R26.1, R27.2, U17.6
unnamed: C95.2, R32.1, R33.2, U19.6
unnamed: C68.2, C103.2, D3.1 (A1), R17.1, U14.1 (-)
unnamed: C68.1, C103.1, D3.2 (A2), R16.1, U14.4 (+)
unnamed: C78.2, C105.2, D6.1 (A1), R23.1, U16.1 (-)
unnamed: C78.1, C105.1, D6.2 (A2), R22.1, U16.4 (+)
unnamed: C88.2, C107.2, D7.1 (A1), R29.1, U18.1 (-)
unnamed: C88.1, C107.1, D7.2 (A2), R28.1, U18.4 (+)
unnamed: R18.1, U14.2 (Rg)
unnamed: R18.2, U14.3 (Rg)
unnamed: R19.2, U14.7
unnamed: R24.1, U16.2 (Rg)
unnamed: R24.2, U16.3 (Rg)
unnamed: R25.2, U16.7
unnamed: R30.1, U18.2 (Rg)
unnamed: R30.2, U18.3 (Rg)
unnamed: R31.2, U18.7
unnamed: C75.1, R19.1, R20.2, U15.2 (-)
unnamed: C85.1, R25.1, R26.2, U17.2 (-)
unnamed: C95.1, R31.1, R32.2, U19.2 (-)

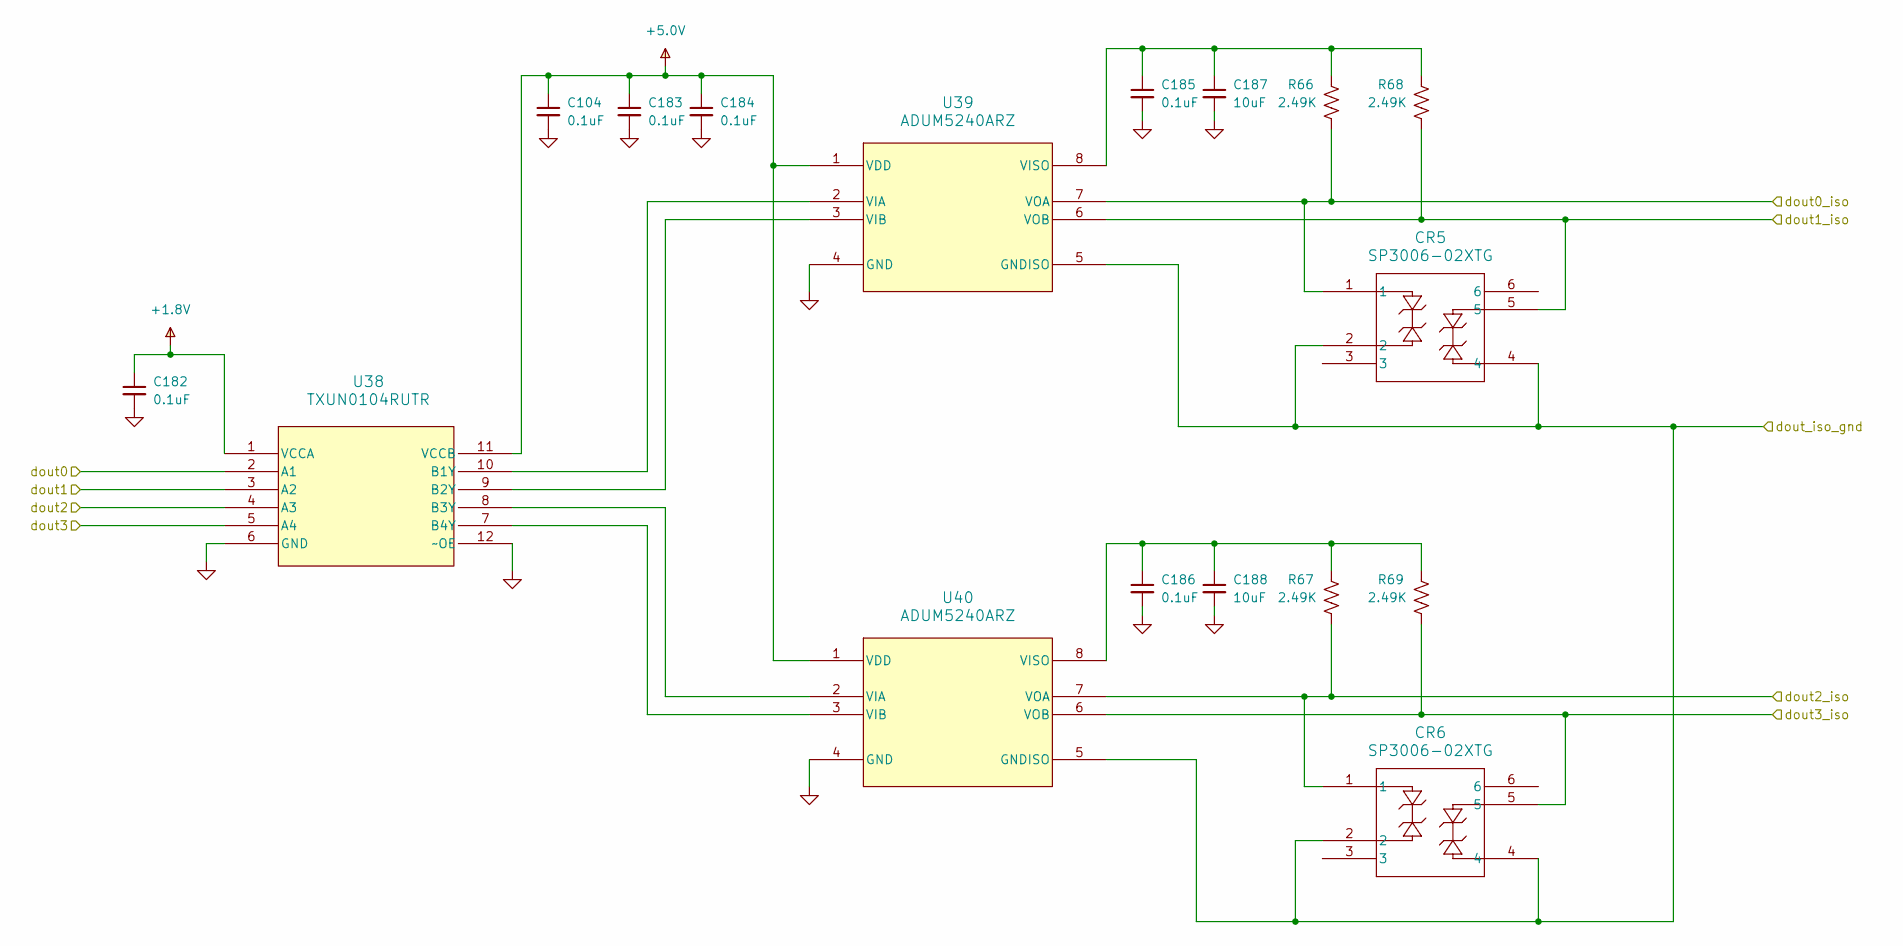
[picture p9: schematic digout.kicad_sch]

Parts:
C104, C182, C183, C184, C185, C186: 0.1uF; C_0402_1005Metric; MFG_PN TMK105BJ104KV-F
C187, C188: 10uF; C_0603_1608Metric; Voltage 25V; MFG_PN CL10A106MA8NRNC
CR5, CR6: SP3006-02XTG; SOT563_LTF; MFG_PN SP3006-02XTG
R66, R67, R68, R69: 2.49K; R_0402_1005Metric; Tolerance 1%; MFG_PN ERJ-2RKF2491X
U38: TXUN0104RUTR; PQFP12_RUT_TEX; MFG_PN TXUN0104RUTR
U39, U40: ADUM5240ARZ; R_8_ADI; MFG_PN ADUM5240ARZ

Connections:
+1.8V: C182.1, U38.1 (VCCA); also elsewhere on the board
+5.0V: C104.1, C183.1, C184.1, U38.11 (VCCB), U39.1 (VDD), U40.1 (VDD); also elsewhere on the board
/FPGA connector/dout0: U38.2 (A1); also elsewhere on the board
/FPGA connector/dout1: U38.3 (A2); also elsewhere on the board
/FPGA connector/dout2: U38.4 (A3); also elsewhere on the board
/FPGA connector/dout3: U38.5 (A4); also elsewhere on the board
/Isolated Digital IO/dout0_iso: CR5.1, R66.1, U39.7 (VOA); also elsewhere on the board
/Isolated Digital IO/dout1_iso: CR5.5, R68.1, U39.6 (VOB); also elsewhere on the board
/Isolated Digital IO/dout2_iso: CR6.1, R67.1, U40.7 (VOA); also elsewhere on the board
/Isolated Digital IO/dout3_iso: CR6.5, R69.1, U40.6 (VOB); also elsewhere on the board
/Isolated Digital IO/dout_iso_gnd: CR5.2, CR5.4, CR6.2, CR6.4, U39.5 (GNDISO), U40.5 (GNDISO); also elsewhere on the board
GND: C104.2, C182.2, C183.2, C184.2, C185.2, C186.2, C187.2, C188.2, U38.6 (GND), U38.12 (~OE), U39.4 (GND), U40.4 (GND); also elsewhere on the board
unnamed: U38.10 (B1Y), U39.2 (VIA)
unnamed: U38.9 (B2Y), U39.3 (VIB)
unnamed: U38.8 (B3Y), U40.2 (VIA)
unnamed: U38.7 (B4Y), U40.3 (VIB)
unnamed: C185.1, C187.1, R66.2, R68.2, U39.8 (VISO)
unnamed: C186.1, C188.1, R67.2, R69.2, U40.8 (VISO)

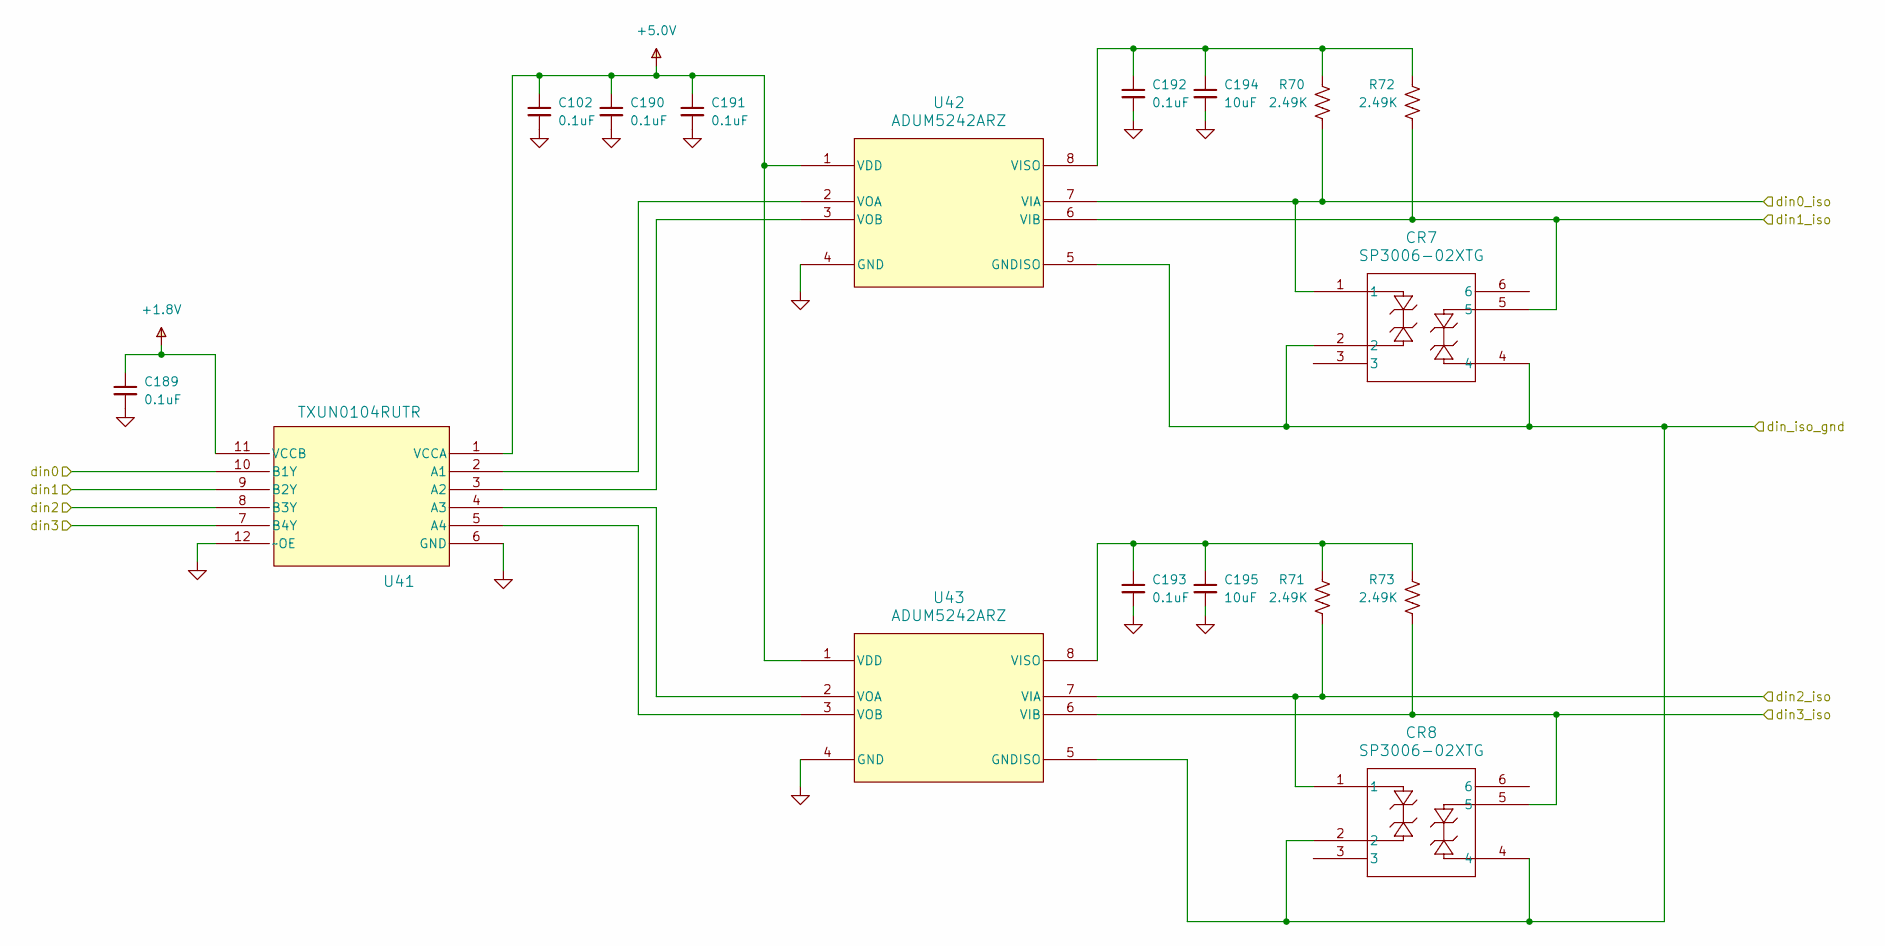
[picture p10: schematic digin.kicad_sch]

Parts:
C102, C189, C190, C191, C192, C193: 0.1uF; C_0402_1005Metric; MFG_PN TMK105BJ104KV-F
C194, C195: 10uF; C_0603_1608Metric; Voltage 25V; MFG_PN CL10A106MA8NRNC
CR7, CR8: SP3006-02XTG; SOT563_LTF; MFG_PN SP3006-02XTG
R70, R71, R72, R73: 2.49K; R_0402_1005Metric; Tolerance 1%; MFG_PN ERJ-2RKF2491X
U41: TXUN0104RUTR; PQFP12_RUT_TEX; MFG_PN TXUN0104RUTR
U42, U43: ADUM5242ARZ; R_8_ADI; MFG_PN ADUM5242ARZ

Connections:
+1.8V: C189.1, U41.11 (VCCB); also elsewhere on the board
+5.0V: C102.1, C190.1, C191.1, U41.1 (VCCA), U42.1 (VDD), U43.1 (VDD); also elsewhere on the board
/FPGA connector/din0: U41.10 (B1Y); also elsewhere on the board
/FPGA connector/din1: U41.9 (B2Y); also elsewhere on the board
/FPGA connector/din2: U41.8 (B3Y); also elsewhere on the board
/FPGA connector/din3: U41.7 (B4Y); also elsewhere on the board
/Isolated Digital IO/din0_iso: CR7.1, R70.1, U42.7 (VIA); also elsewhere on the board
/Isolated Digital IO/din1_iso: CR7.5, R72.1, U42.6 (VIB); also elsewhere on the board
/Isolated Digital IO/din2_iso: CR8.1, R71.1, U43.7 (VIA); also elsewhere on the board
/Isolated Digital IO/din3_iso: CR8.5, R73.1, U43.6 (VIB); also elsewhere on the board
/Isolated Digital IO/din_iso_gnd: CR7.2, CR7.4, CR8.2, CR8.4, U42.5 (GNDISO), U43.5 (GNDISO); also elsewhere on the board
GND: C102.2, C189.2, C190.2, C191.2, C192.2, C193.2, C194.2, C195.2, U41.6 (GND), U41.12 (~OE), U42.4 (GND), U43.4 (GND); also elsewhere on the board
unnamed: U41.2 (A1), U42.2 (VOA)
unnamed: U41.3 (A2), U42.3 (VOB)
unnamed: U41.4 (A3), U43.2 (VOA)
unnamed: U41.5 (A4), U43.3 (VOB)
unnamed: C192.1, C194.1, R70.2, R72.2, U42.8 (VISO)
unnamed: C193.1, C195.1, R71.2, R73.2, U43.8 (VISO)

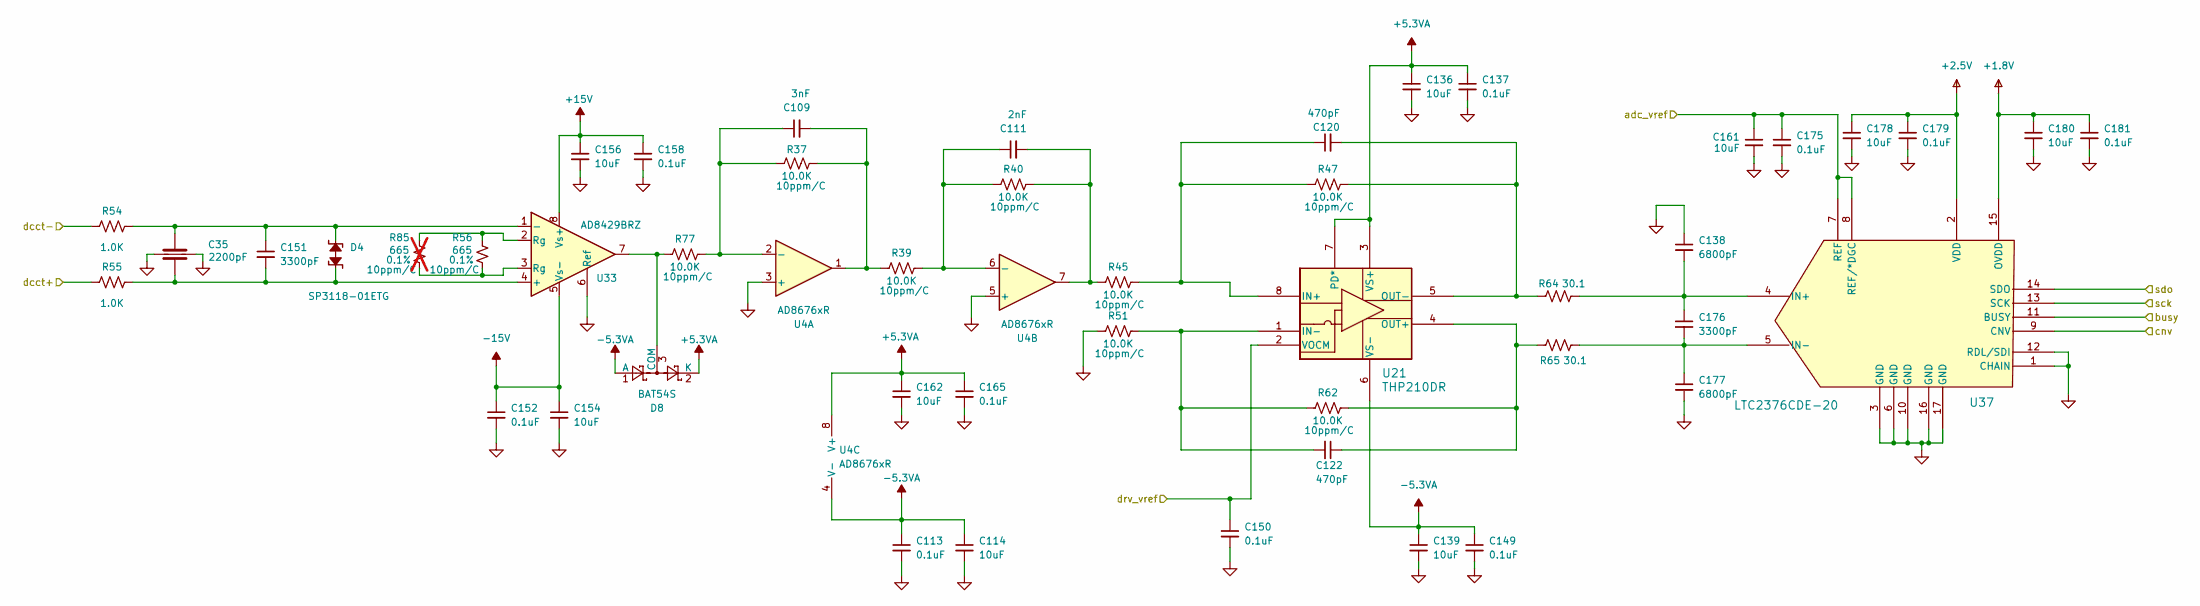
[picture p11: schematic dcct.kicad_sch]

Parts:
C35: 2200pF; EMCT101W222M1GV001E; MFG_PN EMCT101W222M1GV001E
C109: 3nF; C_0603_1608Metric; MFG_PN C0603C302J5GACTU
C111: 2nF; C_0603_1608Metric; MFG_PN C0603C202F5GACTU
C113, C137, C149, C150, C152, C158, C165, C175, C179, C181: 0.1uF; C_0402_1005Metric; MFG_PN TMK105BJ104KV-F
C114, C136, C139, C154, C156, C161, C162, C178, C180: 10uF; C_0603_1608Metric; Voltage 25V; MFG_PN CL10A106MA8NRNC
C120, C122: 470pF; C_0402_1005Metric; MFG_PN GRM1555C1H471FA01D
C138, C177: 6800pF; C_0402_1005Metric; MFG_PN CL05B682KB5NNNC
C151, C176: 3300pF; C_0402_1005Metric; MFG_PN CL05B332KB5NNNC
D4: SP3118-01ETG; sp3118-01etg; MFG_PN SP3118-01ETG
D8: BAT54S; SOT-23; MFG_PN BAT54S
R37, R39, R40, R45, R47, R51, R62, R77: 10.0K; R_0603_1608Metric; Tolerance 0.1%; MFG_PN RT0603BRB0710KL
R54, R55: 1.0K; R_0402_1005Metric; Tolerance 1%; MFG_PN ERJ-2RKF1001X
R56: 665; R_0603_1608Metric; MFG_PN RQ73C1J665RBTD
R64, R65: 30.1; R_0402_1005Metric; Tolerance 1%; MFG_PN ERJ-2RKF30R1X
R85: 665; R_0603_1608Metric; MFG_PN RQ73C1J665RBTD; not fitted
U4: AD8676xR; SOIC-8_3.9x4.9mm_P1.27mm; MFG_PN AD8676BRZ
U21: THP210DR; SOIC_210DR_TEX; MFG_PN THP210DR
U33: AD8429BRZ; SOIC127P600X175-8N; MFG_PN AD8429BRZ
U37: LTC2376CDE-20; DFN-16_DE_LIT; MFG_PN LTC2376CDE-20#PBF

Connections:
+1.8V: C180.1, C181.1, U37.15 (OVDD); also elsewhere on the board
+2.5V: C178.1, C179.1, U37.2 (VDD); also elsewhere on the board
+5.3VA: C136.1, C137.1, C162.1, C165.1, D8.2 (K), U4.8 (V+), U21.3 (VS+), U21.7 (PD*); also elsewhere on the board
+15V: C156.1, C158.1, U33.8 (Vs+); also elsewhere on the board
-5.3VA: C113.1, C114.1, C139.1, C149.1, D8.1 (A), U4.4 (V-), U21.6 (VS-); also elsewhere on the board
-15V: C152.1, C154.1, U33.5 (Vs-); also elsewhere on the board
/DCCT ADCs/DCCT Channel 1/drv_vref: C150.1, U21.2 (VOCM); also elsewhere on the board
/DCCT ADCs/adc_vref: C161.1, C175.1, U37.7 (REF), U37.8 (REF/*DGC); also elsewhere on the board
/DCCT ADCs/dcct0+: R55.2; also elsewhere on the board
/DCCT ADCs/dcct0-: R54.2; also elsewhere on the board
/DCCT ADCs/dcct0_sdo: U37.14 (SDO); also elsewhere on the board
/DCCT ADCs/dcct_busy: U37.11 (BUSY); also elsewhere on the board
/DCCT ADCs/dcct_cnv: U37.9 (CNV); also elsewhere on the board
/DCCT ADCs/dcct_sck: U37.13 (SCK); also elsewhere on the board
GND: C35.3, C35.4, C113.2, C114.2, C136.2, C137.2, C138.1, C139.2, C149.2, C150.2, C152.2, C154.2, C156.2, C158.2, C161.2, C162.2, C165.2, C175.2, C177.2, C178.2, C179.2, C180.2, C181.2, R51.2, U4.3 (+), U4.5 (+), U33.6 (Ref), U37.1 (CHAIN), U37.3 (GND), U37.6 (GND), U37.10 (GND), U37.12 (RDL/SDI), U37.16 (GND), U37.17 (GND); also elsewhere on the board
unnamed: C109.2, R37.1, R39.2, U4.1
unnamed: C111.2, R40.1, R45.2, U4.7
unnamed: C35.2, C151.2, D4.1 (A1), R55.1, U33.4 (+)
unnamed: C35.1, C151.1, D4.2 (A2), R54.1, U33.1 (-)
unnamed: D8.3 (COM), R77.2, U33.7
unnamed: R56.1, R85.1, U33.2 (Rg)
unnamed: R56.2, R85.2, U33.3 (Rg)
unnamed: C109.1, R37.2, R77.1, U4.2 (-)
unnamed: C111.1, R39.1, R40.2, U4.6 (-)
unnamed: C120.1, R45.1, R47.2, U21.8 (IN+)
unnamed: C122.2, R51.1, R62.2, U21.1 (IN-)
unnamed: C122.1, R62.1, R65.2, U21.4 (OUT+)
unnamed: C120.2, R47.1, R64.2, U21.5 (OUT-)
unnamed: C138.2, C176.1, R64.1, U37.4 (IN+)
unnamed: C176.2, C177.1, R65.1, U37.5 (IN-)

Parts of its further copies:
C38: 2200pF; EMCT101W222M1GV001E; MFG_PN EMCT101W222M1GV001E
C110: 3nF; C_0603_1608Metric; MFG_PN C0603C302J5GACTU
C112: 2nF; C_0603_1608Metric; MFG_PN C0603C202F5GACTU
C115, C117, C123, C130, C144, C146, C159, C173, C174, C196: 0.1uF; C_0402_1005Metric; MFG_PN TMK105BJ104KV-F
C116, C141: 3300pF; C_0402_1005Metric; MFG_PN CL05B332KB5NNNC
C118, C119, C121, C127, C143, C145, C169, C171, C172: 10uF; C_0603_1608Metric; Voltage 25V; MFG_PN CL10A106MA8NRNC
C128, C129: 470pF; C_0402_1005Metric; MFG_PN GRM1555C1H471FA01D
C140, C142: 6800pF; C_0402_1005Metric; MFG_PN CL05B682KB5NNNC
D5: SP3118-01ETG; sp3118-01etg; MFG_PN SP3118-01ETG
D9: BAT54S; SOT-23; MFG_PN BAT54S
R35, R38, R41, R44, R46, R48, R58, R63: 10.0K; R_0603_1608Metric; Tolerance 0.1%; MFG_PN RT0603BRB0710KL
R36: 665; R_0603_1608Metric; MFG_PN RQ73C1J665RBTD
R42, R43: 1.0K; R_0402_1005Metric; Tolerance 1%; MFG_PN ERJ-2RKF1001X
R52, R53: 30.1; R_0402_1005Metric; Tolerance 1%; MFG_PN ERJ-2RKF30R1X
R86: 665; R_0603_1608Metric; MFG_PN RQ73C1J665RBTD; not fitted
U8: AD8676xR; SOIC-8_3.9x4.9mm_P1.27mm; MFG_PN AD8676BRZ
U26: THP210DR; SOIC_210DR_TEX; MFG_PN THP210DR
U27: AD8429BRZ; SOIC127P600X175-8N; MFG_PN AD8429BRZ
U31: LTC2376CDE-20; DFN-16_DE_LIT; MFG_PN LTC2376CDE-20#PBF

Connections of its further copies:
+1.8V: C145.1, C146.1, U31.15 (OVDD); also elsewhere on the board
+2.5V: C143.1, C144.1, U31.2 (VDD); also elsewhere on the board
+5.3VA: C127.1, C130.1, C171.1, C173.1, D9.2 (K), U8.8 (V+), U26.3 (VS+), U26.7 (PD*); also elsewhere on the board
+15V: C121.1, C123.1, U27.8 (Vs+); also elsewhere on the board
-5.3VA: C115.1, C118.1, C172.1, C174.1, D9.1 (A), U8.4 (V-), U26.6 (VS-); also elsewhere on the board
-15V: C117.1, C119.1, U27.5 (Vs-); also elsewhere on the board
/DCCT ADCs/DCCT Channel 1/drv_vref: C159.1, U26.2 (VOCM); also elsewhere on the board
/DCCT ADCs/DCCT Channel 2/busy: U31.11 (BUSY)
/DCCT ADCs/adc_vref: C169.1, C196.1, U31.7 (REF), U31.8 (REF/*DGC); also elsewhere on the board
/DCCT ADCs/dcct1+: R43.2; also elsewhere on the board
/DCCT ADCs/dcct1-: R42.2; also elsewhere on the board
/DCCT ADCs/dcct1_sdo: U31.14 (SDO); also elsewhere on the board
/DCCT ADCs/dcct_cnv: U31.9 (CNV); also elsewhere on the board
/DCCT ADCs/dcct_sck: U31.13 (SCK); also elsewhere on the board
GND: C38.3, C38.4, C115.2, C117.2, C118.2, C119.2, C121.2, C123.2, C127.2, C130.2, C140.1, C142.2, C143.2, C144.2, C145.2, C146.2, C159.2, C169.2, C171.2, C172.2, C173.2, C174.2, C196.2, R58.2, U8.3 (+), U8.5 (+), U27.6 (Ref), U31.1 (CHAIN), U31.3 (GND), U31.6 (GND), U31.10 (GND), U31.12 (RDL/SDI), U31.16 (GND), U31.17 (GND); also elsewhere on the board
unnamed: C110.2, R38.1, R41.2, U8.1
unnamed: C112.2, R44.1, R46.2, U8.7
unnamed: C38.2, C116.2, D5.1 (A1), R43.1, U27.4 (+)
unnamed: C38.1, C116.1, D5.2 (A2), R42.1, U27.1 (-)
unnamed: D9.3 (COM), R35.2, U27.7
unnamed: R36.1, R86.1, U27.2 (Rg)
unnamed: R36.2, R86.2, U27.3 (Rg)
unnamed: C110.1, R35.1, R38.2, U8.2 (-)
unnamed: C112.1, R41.1, R44.2, U8.6 (-)
unnamed: C128.1, R46.1, R48.2, U26.8 (IN+)
unnamed: C129.2, R58.1, R63.2, U26.1 (IN-)
unnamed: C129.1, R53.2, R63.1, U26.4 (OUT+)
unnamed: C128.2, R48.1, R52.2, U26.5 (OUT-)
unnamed: C140.2, C141.1, R52.1, U31.4 (IN+)
unnamed: C141.2, C142.1, R53.1, U31.5 (IN-)

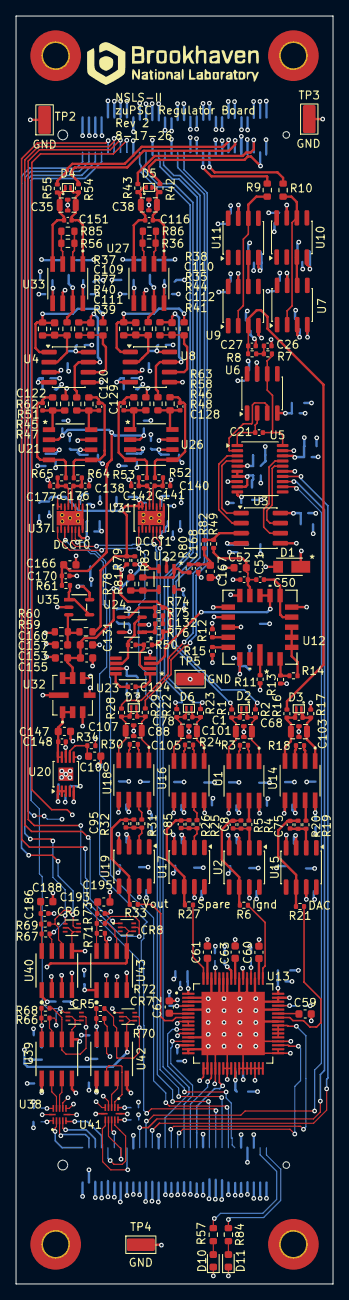
[picture p12: board psc_daughter_brd.kicad_pcb from above]

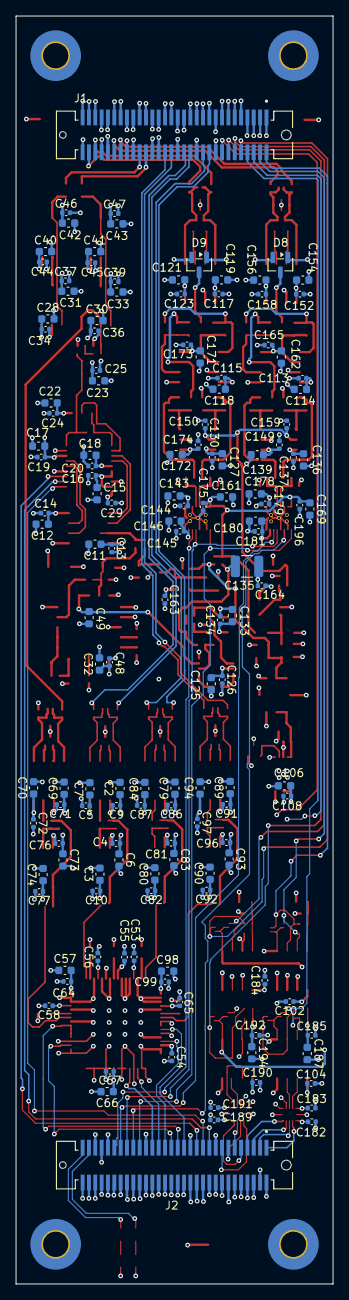
[picture p13: board psc_daughter_brd.kicad_pcb from below]

Board: 10 copper layers, 40.0 x 160.0 mm, 344 parts (141 on the bottom side), 176 nets.
